wuji-technology/wuji-description/hand/attachment/wuji-hand-rl-open-source-base/BOM.xlsx

Preview | No. | Drawing No. / Spec (Model) | Part Name | Qty | Material | Finish | Brand | Type | Remark | File Name
 | 1 | 350x200x13 | Aluminum Optical Breadboard | 1 | AL6061-T6(SS) | Black Anodized |  | Standard Part |  | 350x200x13 Aluminum Optical Breadboard
 | 2 | Wuji Hand-RL Open-Source Fixture-01B | Base | 1 | PLA or other 3D printing material | N/A |  | Custom Part | 3D Printed | Wuji Hand-RL Open-Source Fixture-01B Base
