wuji-technology/wuji-description/hand/attachment/wuji-hand-rl-open-source-base/Assembly.STEP

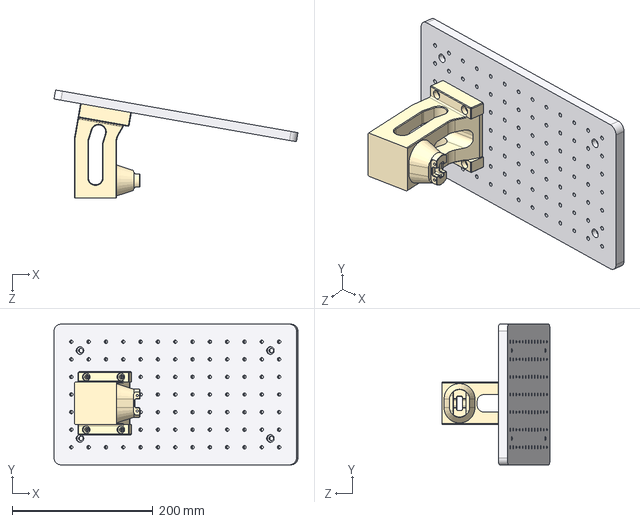
[picture p1: CAD file, 2026-06-10]
hand/attachment/wuji-hand-rl-open-source-base/Assembly.STEP
346.9 x 200.0 x 153.7 mm
Wuji Hand-RL Open-Source Fixture-01B Base
350x200x13 Aluminum Optical Breadboard
