wuji-technology/wuji-description/hand2/hand2_1/body/meshes/left/visual_nails/l_ring_finger_distal_black_remainder.STL

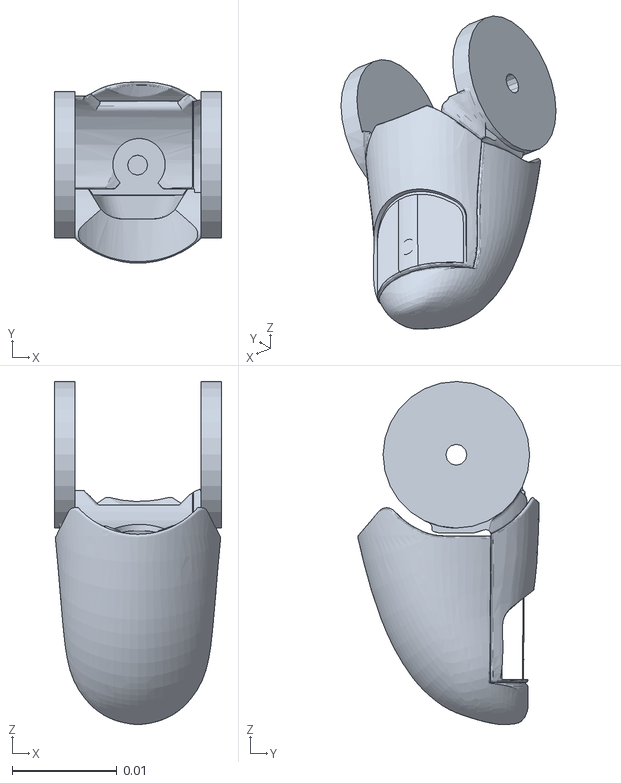
[picture p2: CAD file, 2026-10-26]
hand2/hand2_1/body/meshes/left/visual_nails/l_ring_finger_distal_black_remainder.STL
0.016 x 0.0173 x 0.0328
