wuji-technology/wuji-description/hand2/hand2_2/body/meshes/right/visual_nails/r_pinky_distal_black_remainder.STL

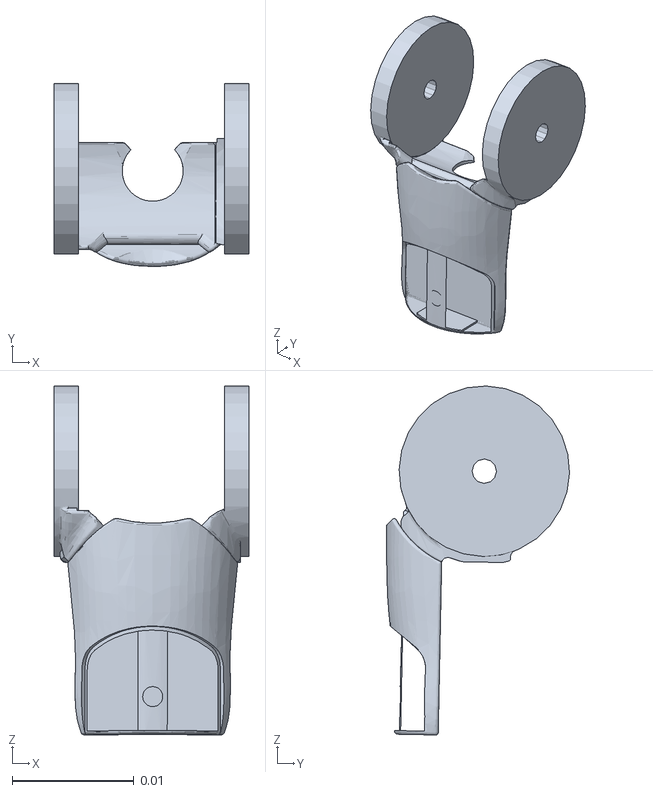
[picture p3: CAD file, 2026-10-26]
hand2/hand2_2/body/meshes/right/visual_nails/r_pinky_distal_black_remainder.STL
0.016 x 0.015 x 0.0287
