wuji-technology/wuji-description/glove/attachment/Pico-controller-attachment.STEP

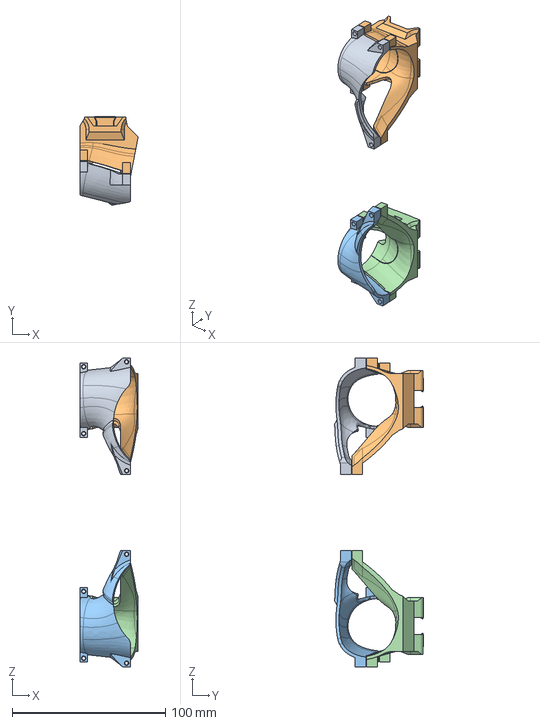
[picture p4: CAD file, 2026-10-26]
glove/attachment/Pico-controller-attachment.STEP
38.1 x 58.0 x 201.6 mm
