wuji-technology/wuji-description/glove/body/mesh/base_link_TX.STL

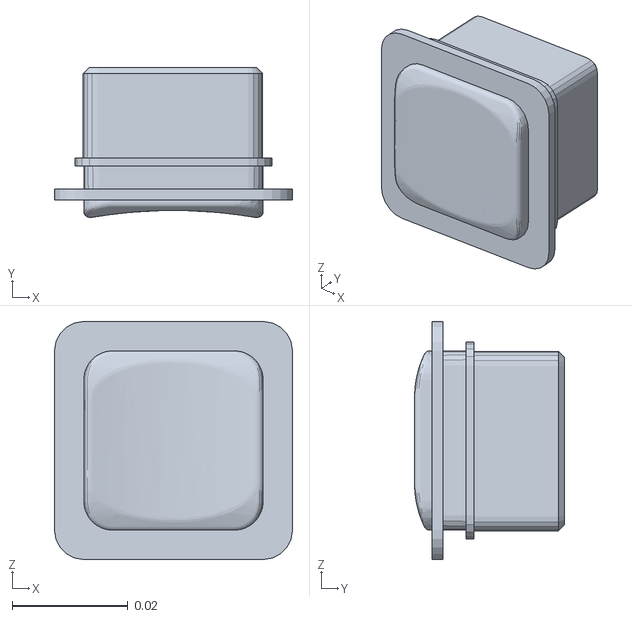
[picture p5: CAD file, 2026-09-11]
glove/body/mesh/base_link_TX.STL
0.0411 x 0.0259 x 0.0411
