wuji-technology/wuji-description/glove/body/step/EMFTXC_topcover.step

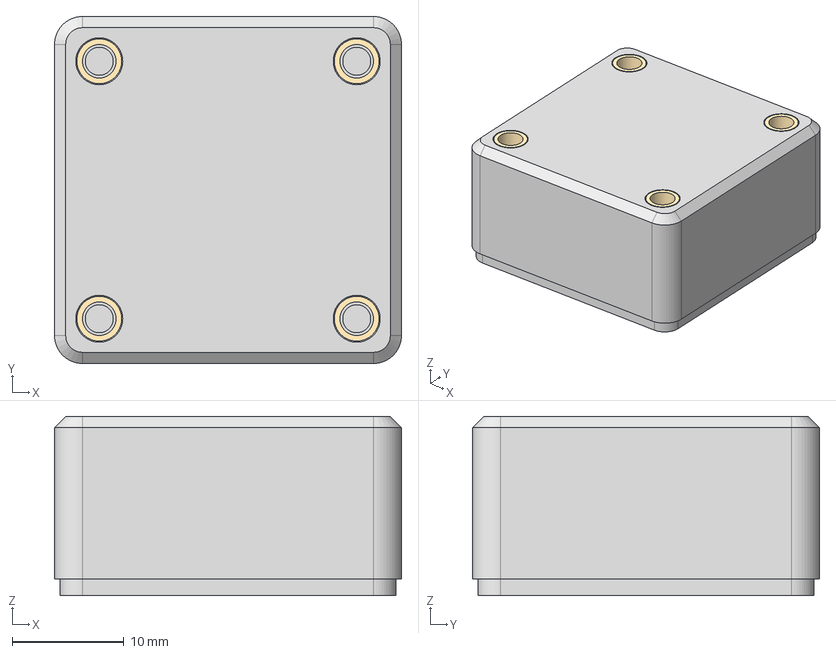
[picture p6: CAD file, 2026-06-04]
glove/body/step/EMFTXC_topcover.step
31.0 x 31.0 x 16.0 mm
M3_4.5_6
YC.JG.WJ01218
YC.JG.WJ01218_1
YC.JG.WJ01218_2
