wuji-technology/wuji-description/hand/attachment/impact-resistant-attachment/meshes/hand_docking_link.STL

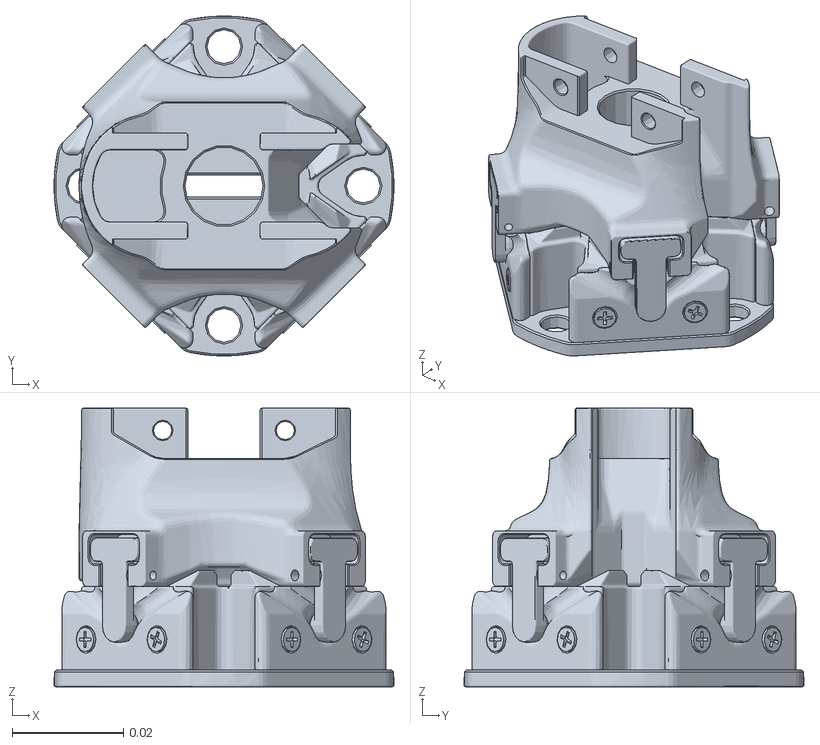
[picture p7: CAD file, 2026-05-18]
hand/attachment/impact-resistant-attachment/meshes/hand_docking_link.STL
0.061 x 0.061 x 0.05
