wuji-technology/wuji-description/hand/attachment/step/Impact-Resistant-Adapter.step

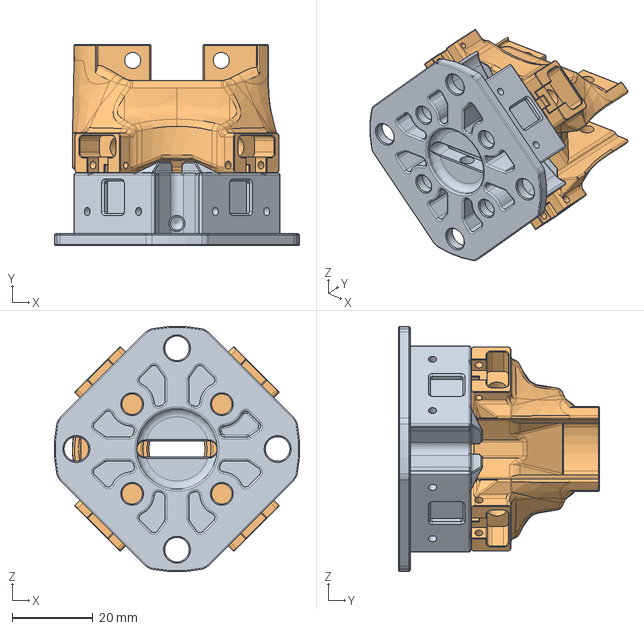
[picture p8: CAD file, 2026-05-18]
hand/attachment/step/Impact-Resistant-Adapter.step
60.9 x 50.0 x 60.9 mm
YC.JG.QX00600
YC.JG.QX00601
