wuji-technology/wuji-description/hand/attachment/unitree-g1-attachment/unitree-g1-docking-adapter.stl

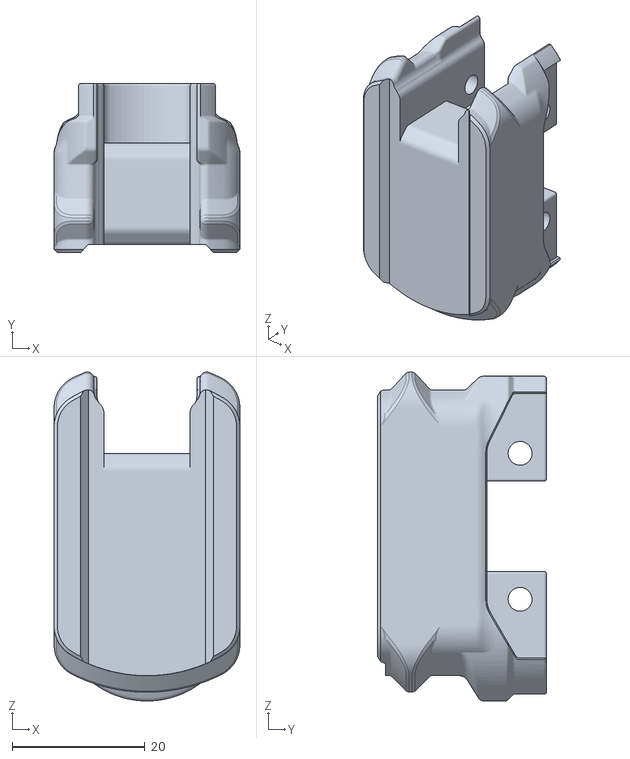
[picture p9: CAD file, 2026-05-18]
hand/attachment/unitree-g1-attachment/unitree-g1-docking-adapter.stl
28.0 x 25.5 x 49.6
