wuji-technology/wuji-description/hand/body-with-soft/meshes/left/left_finger5_link4_simplified.STL

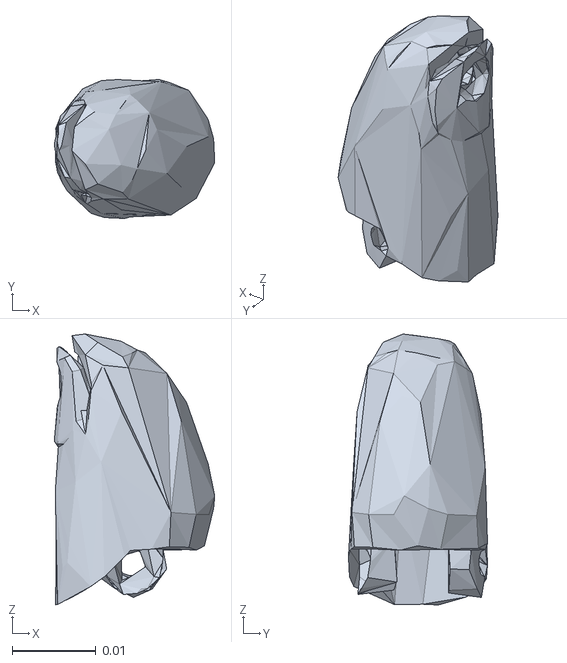
[picture p10: CAD file, 2026-06-10]
hand/body-with-soft/meshes/left/left_finger5_link4_simplified.STL
0.0191 x 0.0166 x 0.0323
