wuji-technology/wuji-description/hand/body-with-soft/meshes/right/right_finger1_link3.STL

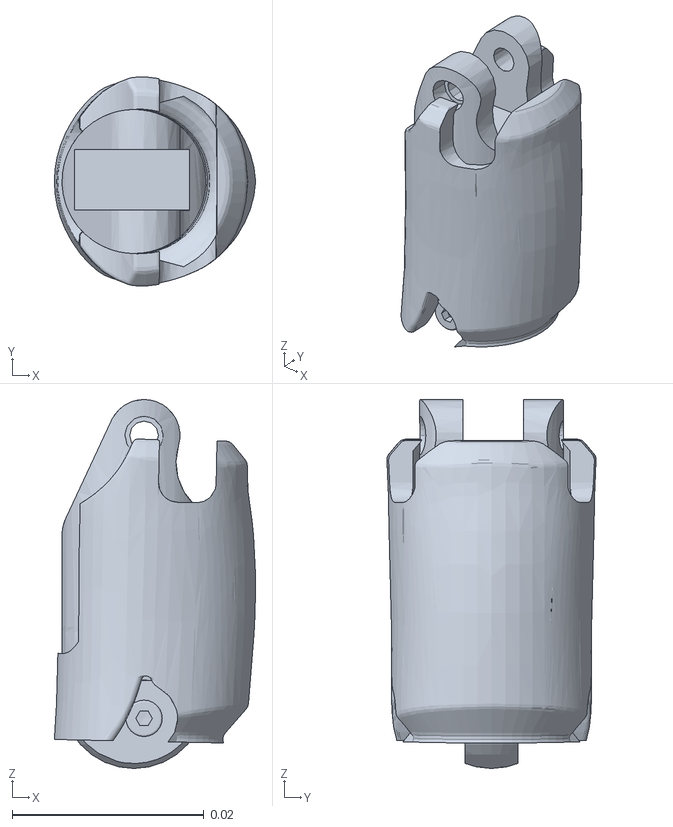
[picture p11: CAD file, 2026-06-10]
hand/body-with-soft/meshes/right/right_finger1_link3.STL
0.021 x 0.0218 x 0.0385
