wuji-technology/wuji-description/hand/body/step/WH_simplified_left_frame&temporarytips.STEP

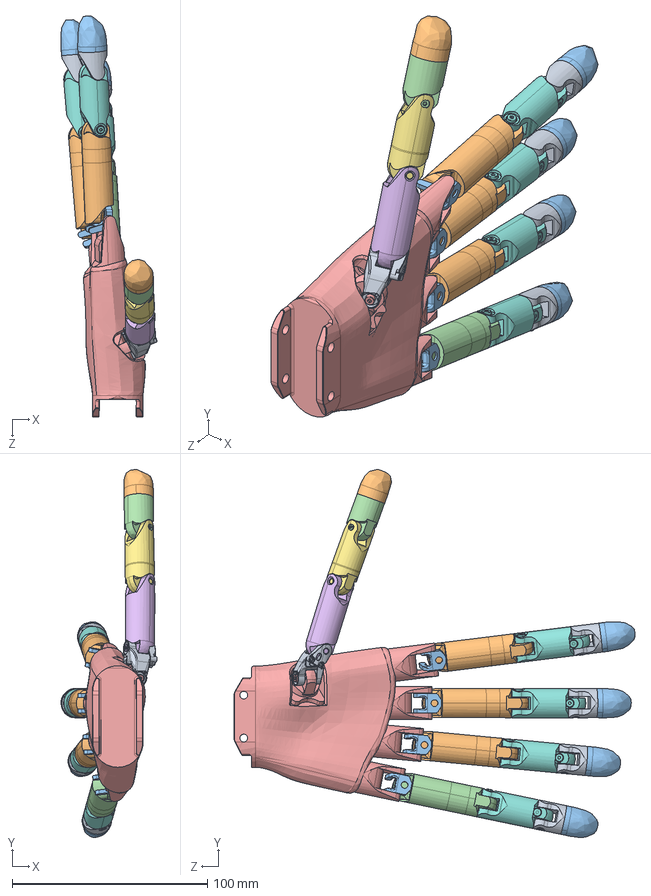
[picture p12: CAD file, 2026-05-18]
hand/body/step/WH_simplified_left_frame&temporarytips.STEP
49.3 x 188.8 x 205.5 mm
_X2_87178F6E87176746_X0_IP.step
MCP_joint_index.step
_X2_87178F6E87176746_X0_IP_2.step
MCP_joint_index_1.step
MCP_joint_index_2.step
_X2_87178F6E87176746_X0_IP_3.step
MCP_joint_index_3.step
_X2_87178F6E87176746_X0_IP_4.step
_X2_65E068079898_X0_.step
_X2_87178F6E87176746_X0_IP_1_3_1.step
UJ.WJ.AA.0005.step
_X2_53F3624B_X0_CMC_X2_4E004E8C8F748FDE63A54EF6673A52A07248_X0_ _v29.step
YC.JG.QX00006.step.step x 4
tipmount_index x 4
fingertip_thumb
UJ.WJ.AA.0004 x 4
IP_thumb
