wuji-technology/wuji-description/hand2/hand2_1/attachment/wuji-hand2-description-right-adapter_hand2_1_step.STEP

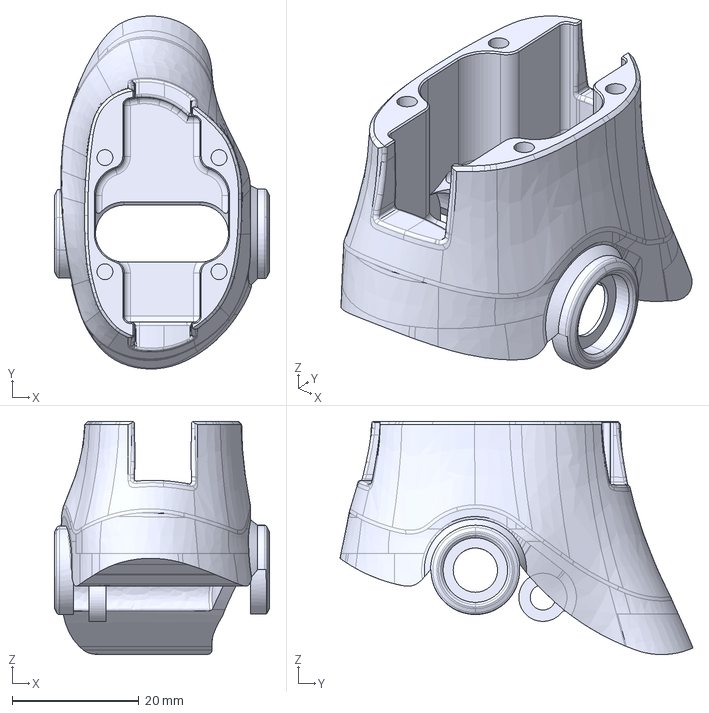
[picture p13: CAD file, 2026-10-26]
hand2/hand2_1/attachment/wuji-hand2-description-right-adapter_hand2_1_step.STEP
34.0 x 55.8 x 36.8 mm
