wuji-technology/wuji-description/hand2/hand2_1/body/meshes/left/l_ring_finger_middle_cover.STL

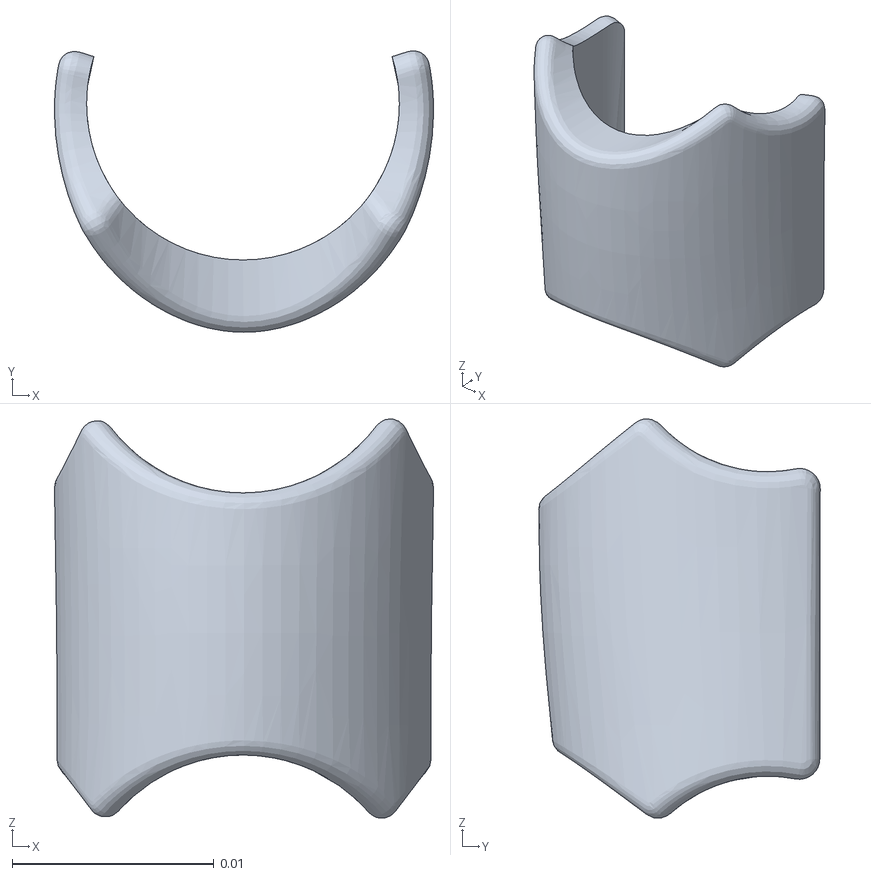
[picture p14: CAD file, 2026-10-26]
hand2/hand2_1/body/meshes/left/l_ring_finger_middle_cover.STL
0.0188 x 0.014 x 0.0198
