wuji-technology/wuji-description/hand2/hand2_1/body/meshes/right/r_thumb_palm_cover.STL

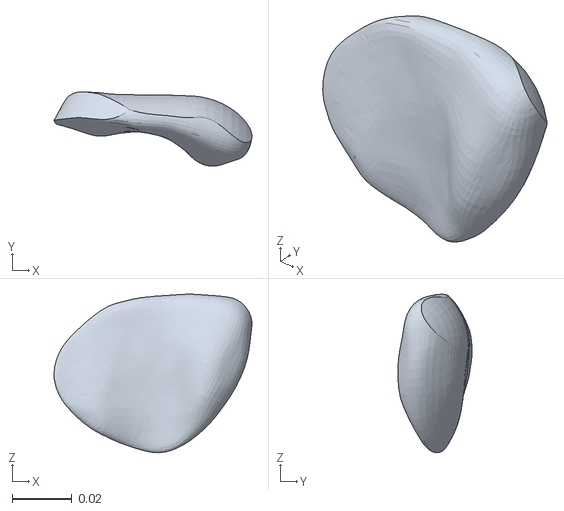
[picture p15: CAD file, 2026-10-26]
hand2/hand2_1/body/meshes/right/r_thumb_palm_cover.STL
0.0664 x 0.0249 x 0.0532
