wuji-technology/wuji-description/hand2/hand2_1/body/step/wuji-hand2-description-left_hand2_1_step.STEP

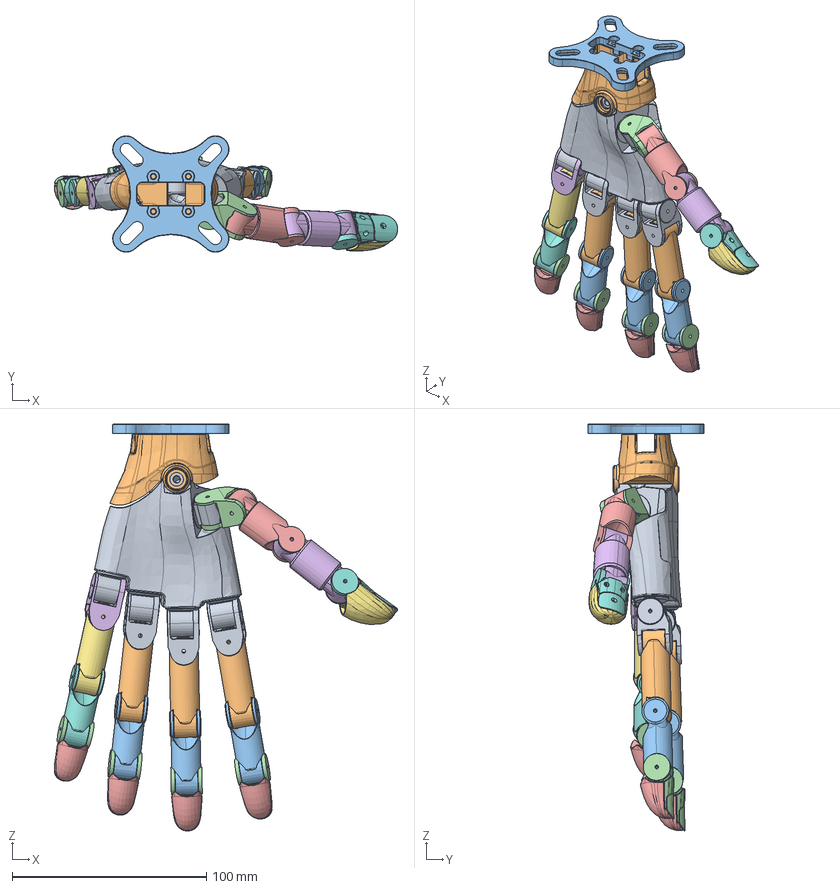
[picture p16: CAD file, 2026-11-10]
hand2/hand2_1/body/step/wuji-hand2-description-left_hand2_1_step.STEP
176.9 x 60.0 x 209.6 mm
l_transfer_001
flange_001
l_wrist_001 x 2
l_thumb_proximal_001
l_thumb_proximal_abd_001
l_thumb_middle_001
l_thumb-tip-sensor_001 x 2
l_thumb_tip_001 x 2
standard_finger_proximal_001 x 3
standard_finger_proximal_abd_001 x 3
standard_finger_middle_001 x 3
standard_tip_001 x 8
standard_tip_001_change x 8
pinky_finger_proximal_001
pinky_finger_proximal_abd_001
pinky_finger_middle_001
