wuji-technology/wuji-description/hand2/hand2_2/attachment/wuji-hand2-description-left-mount_hand2_2_step.STEP

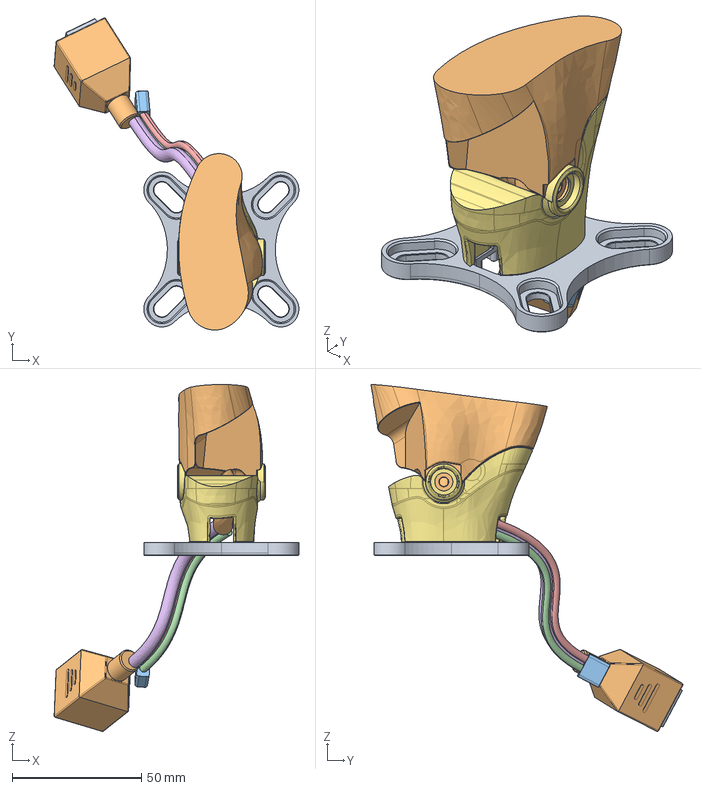
[picture p17: CAD file, 2026-08-14]
hand2/hand2_2/attachment/wuji-hand2-description-left-mount_hand2_2_step.STEP
94.6 x 120.6 x 134.1 mm
线束
WUJI二代灵巧手转接座_beta1版_ 0722
