wuji-technology/wuji-description/hand2/hand2_2/body/meshes/left/l_index_finger_proximal_abd_cover.STL

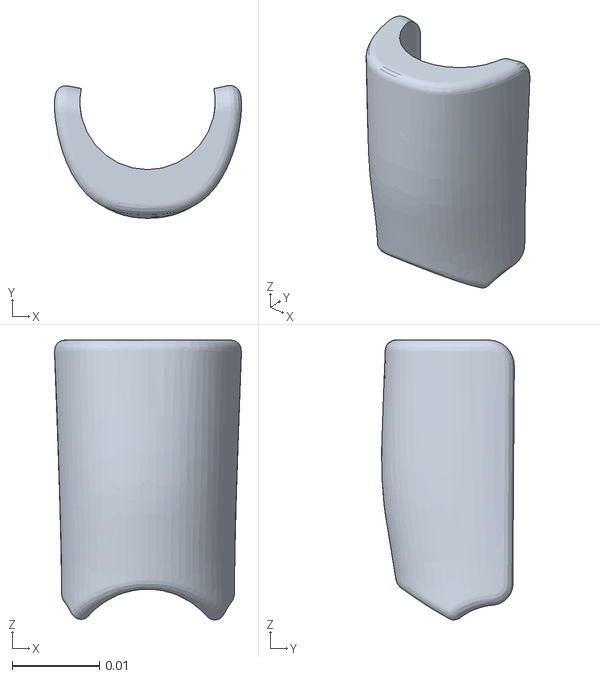
[picture p18: CAD file, 2026-10-26]
hand2/hand2_2/body/meshes/left/l_index_finger_proximal_abd_cover.STL
0.0214 x 0.0152 x 0.0321
