wuji-technology/wuji-description/hand2/hand2_2/body/meshes/left/visual_nails/l_middle_finger_distal_nail_cap.STL

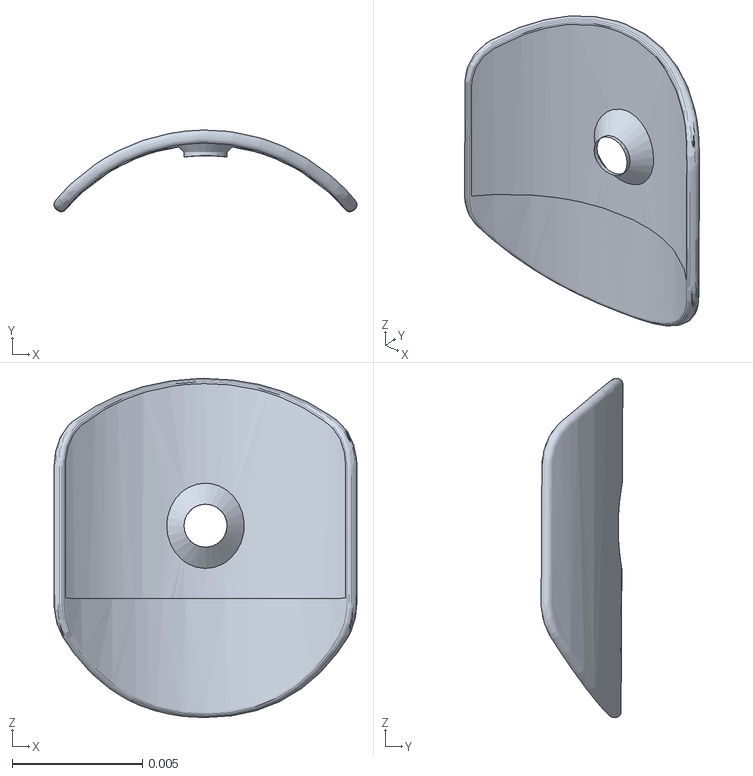
[picture p19: CAD file, 2026-10-26]
hand2/hand2_2/body/meshes/left/visual_nails/l_middle_finger_distal_nail_cap.STL
0.0116 x 0.00314 x 0.013
