wuji-technology/wuji-description/hand2/hand2_2/body/meshes/right/r_thenar_cover.STL

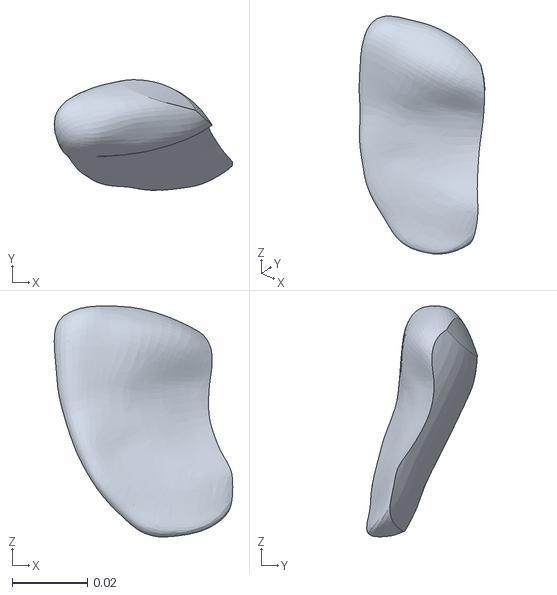
[picture p20: CAD file, 2026-10-26]
hand2/hand2_2/body/meshes/right/r_thenar_cover.STL
0.0476 x 0.0295 x 0.0616
