wuji-technology/wuji-description/hand2/hand2_beta1/attachment/wuji-hand2-description-right-mount_beta1_step.STEP

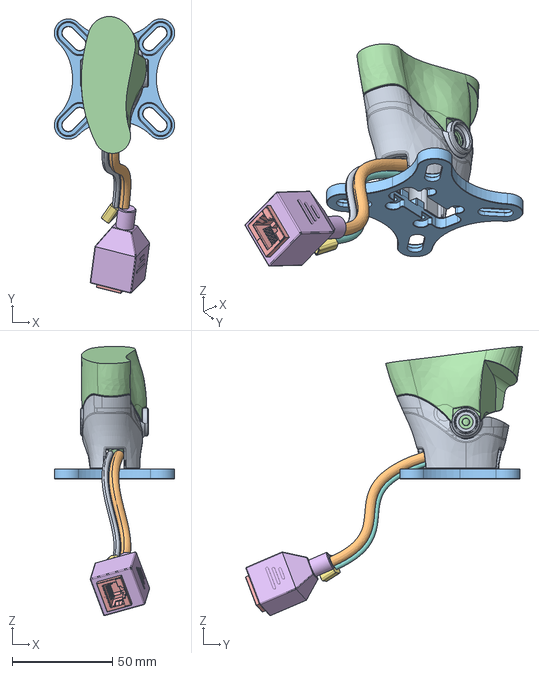
[picture p21: CAD file, 2026-08-14]
hand2/hand2_beta1/attachment/wuji-hand2-description-right-mount_beta1_step.STEP
59.9 x 138.0 x 134.1 mm
WUJI二代灵巧手转接座_beta1版_ 0722
线束
