wuji-technology/wuji-description/hand2/hand2_beta1/body/meshes/left/l_mount.STL

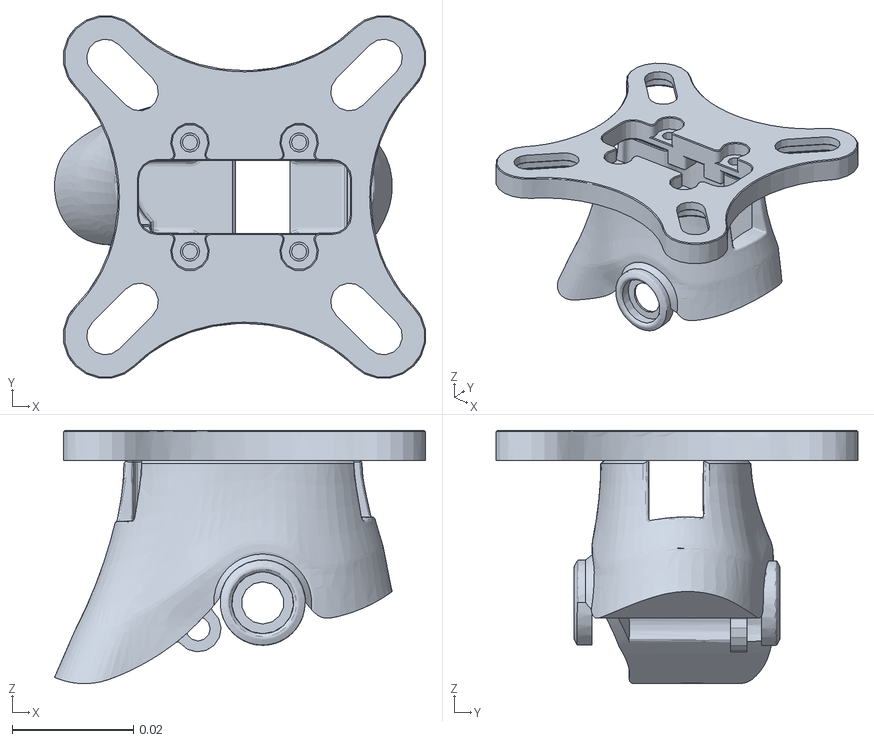
[picture p22: CAD file, 2026-08-14]
hand2/hand2_beta1/body/meshes/left/l_mount.STL
0.0613 x 0.0598 x 0.0418
