wuji-technology/wuji-description/hand2/hand2_beta2/body/meshes/left/l_index_finger_tip_sensor_frame.STL

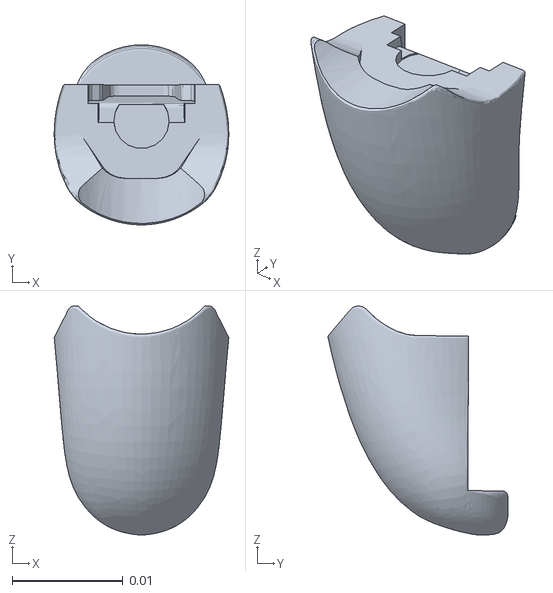
[picture p23: CAD file, 2026-08-14]
hand2/hand2_beta2/body/meshes/left/l_index_finger_tip_sensor_frame.STL
0.0158 x 0.0163 x 0.0207
