wuji-technology/wuji-description/hand2/hand2_beta2/body/meshes/right/r_index_finger_middle.STL

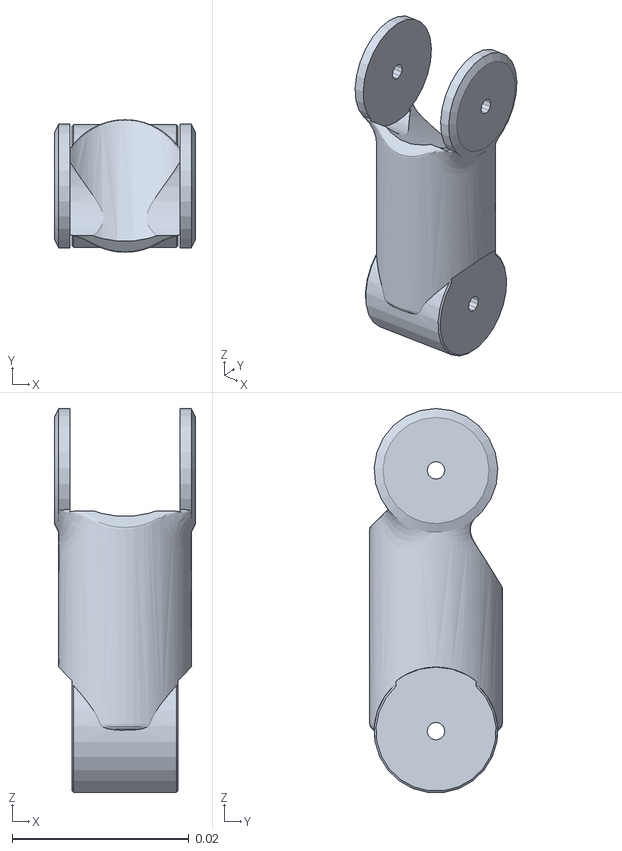
[picture p24: CAD file, 2026-08-14]
hand2/hand2_beta2/body/meshes/right/r_index_finger_middle.STL
0.016 x 0.015 x 0.0434
