wuji-technology/wuji-description/glove/attachment/Wuji-glove-attachment.STEP

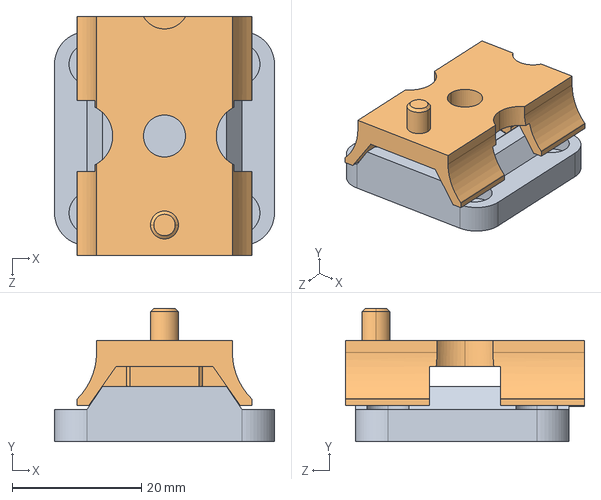
[picture p25: CAD file, 2026-07-14]
glove/attachment/Wuji-glove-attachment.STEP
34.0 x 20.6 x 37.0 mm
wuji glove插销件-v2
手腕插销件-v23
