wuji-technology/wuji-description/glove/body/mesh/base_link_RX.STL

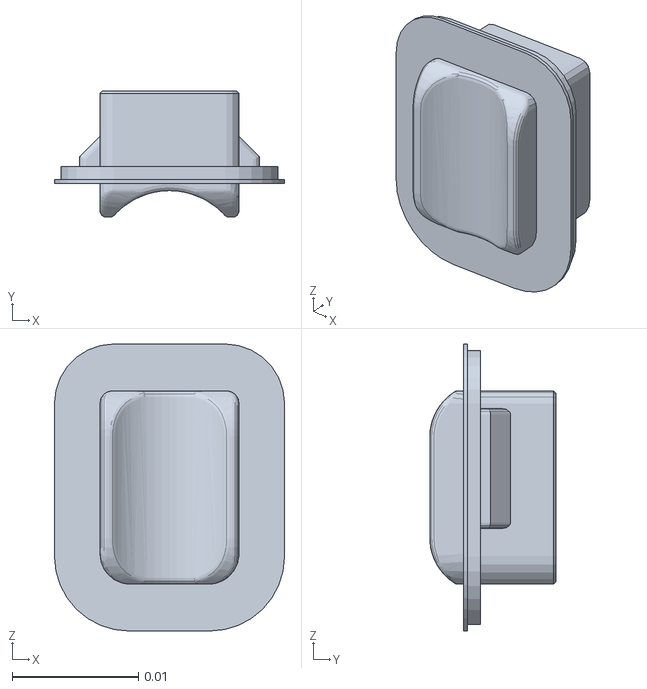
[picture p26: CAD file, 2026-06-04]
glove/body/mesh/base_link_RX.STL
0.0182 x 0.01 x 0.0227
