wuji-technology/wuji-description/hand/attachment/step/Direct-Adapter-Mount.step

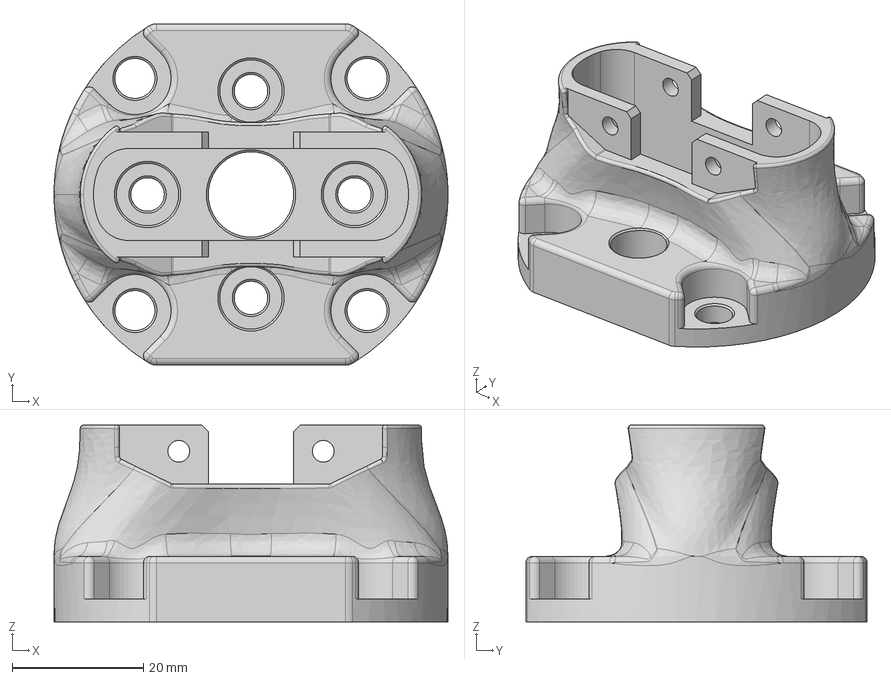
[picture p27: CAD file, 2026-05-18]
hand/attachment/step/Direct-Adapter-Mount.step
60.0 x 52.0 x 30.0 mm
