wuji-technology/wuji-description/hand/attachment/wuji-hand-rl-open-source-base/Base.3mf

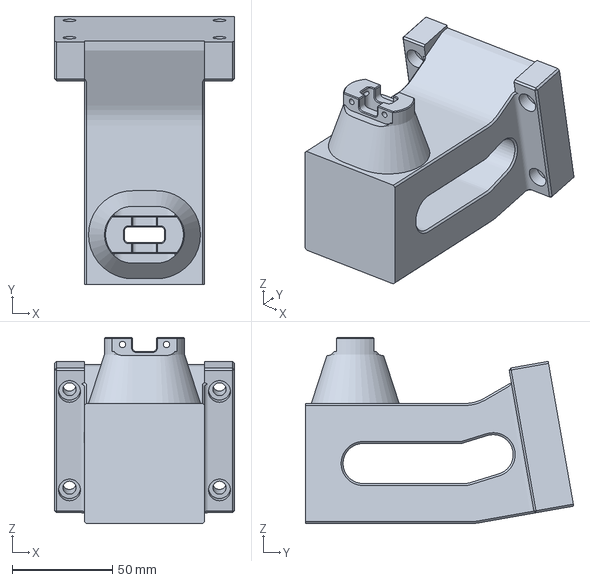
[picture p28: CAD file, 2026-06-10]
hand/attachment/wuji-hand-rl-open-source-base/Base.3mf
90.0 x 134.2 x 93.0 mm
