wuji-technology/wuji-description/hand/body-with-soft/meshes/left/left_finger4_link3.STL

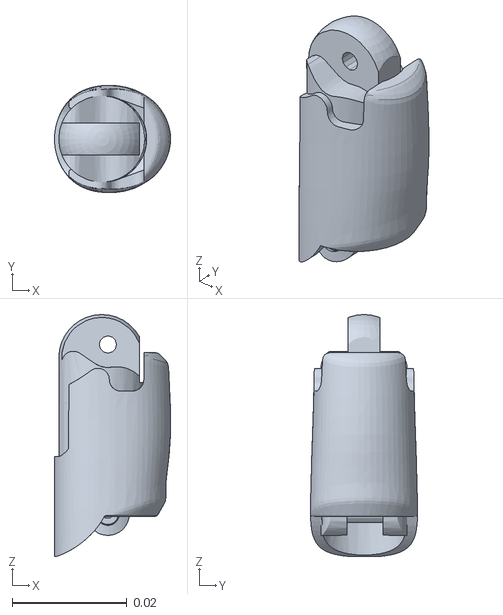
[picture p29: CAD file, 2026-06-10]
hand/body-with-soft/meshes/left/left_finger4_link3.STL
0.0202 x 0.0187 x 0.0422
