wuji-technology/wuji-description/hand/body-with-soft/meshes/right/right_finger5_link3.STL

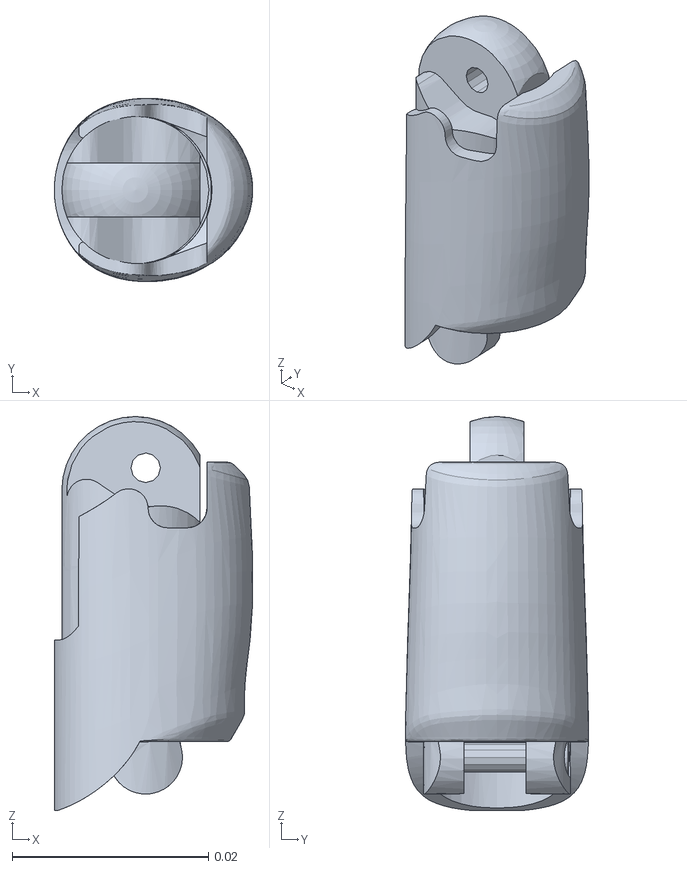
[picture p30: CAD file, 2026-06-10]
hand/body-with-soft/meshes/right/right_finger5_link3.STL
0.0202 x 0.0187 x 0.0402
