wuji-technology/wuji-description/hand/body/step/WH_simplified_right_frame&temporarytips.STEP

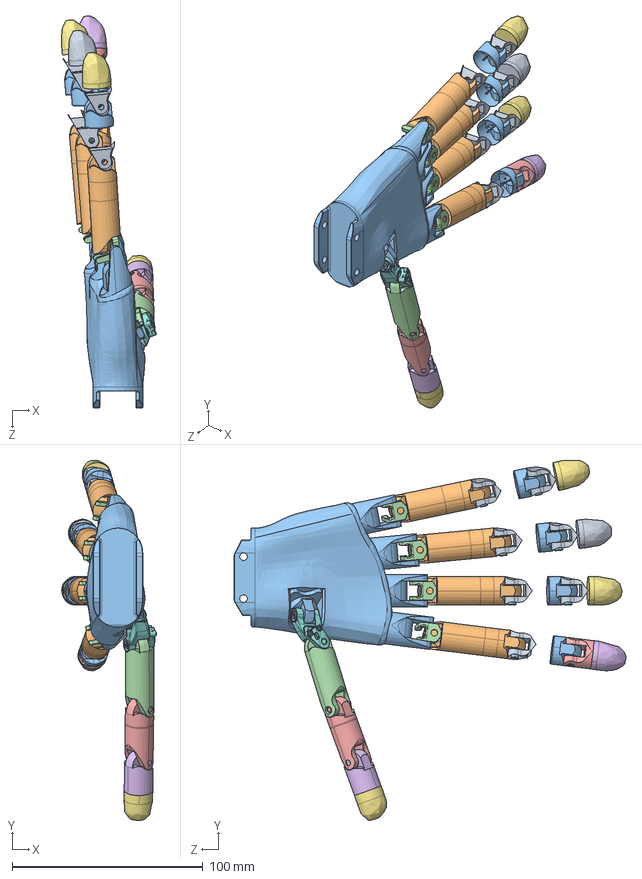
[picture p31: CAD file, 2026-05-18]
hand/body/step/WH_simplified_right_frame&temporarytips.STEP
49.7 x 189.0 x 205.5 mm
_X2_87178F6E87176746_X0_IP
_X2_87178F6E87176746_X0_IP_1
MCP_joint_index
tipmount_index
UJ.WJ.AA.0004
UJ.WJ.AA.0004_1
tipmount_middle
_X2_87178F6E87176746_X0_IP_2
_X2_87178F6E87176746_X0_IP_1_1
MCP_joint_index_1
MCP_joint_index_2
_X2_87178F6E87176746_X0_IP_3
_X2_87178F6E87176746_X0_IP_1_2
UJ.WJ.AA.0004_2
tipmount_ring
MCP_joint_index_3
_X2_87178F6E87176746_X0_IP_1_3
UJ.WJ.AA.0004_3
tipmount_pinky
_X2_87178F6E87176746_X0_IP_4
_X2_65E068079898_X0_
_X2_87178F6E87176746_X0_IP_1_3_1
UJ.WJ.AA.0005
IP_thumb
fingertip_thumb
_X2_53F3624B_X0_CMC_X2_4E004E8C8F748FDE63A54EF6673A52A07248_X0_ _v29
