wuji-technology/wuji-description/hand2/hand2_1/body/meshes/left/l_palm_middle_cover.STL

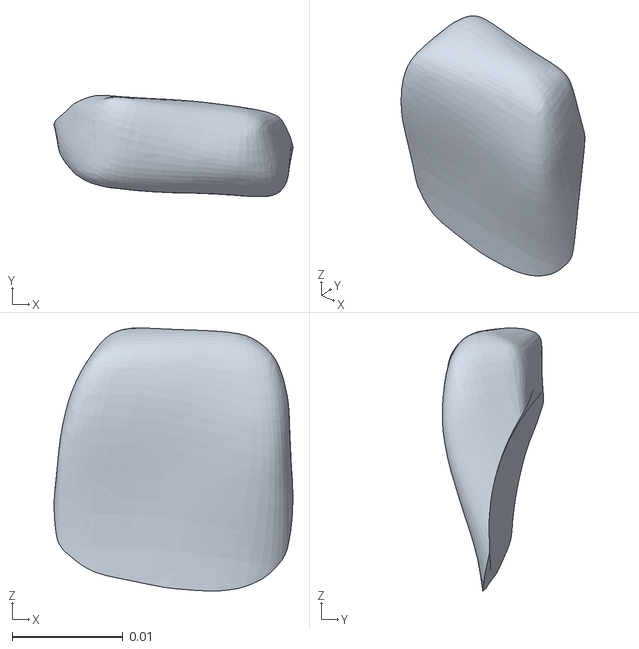
[picture p32: CAD file, 2026-10-26]
hand2/hand2_1/body/meshes/left/l_palm_middle_cover.STL
0.0216 x 0.00916 x 0.0237
