wuji-technology/wuji-description/hand2/hand2_1/body/meshes/right/r_ring_palm_cover.STL

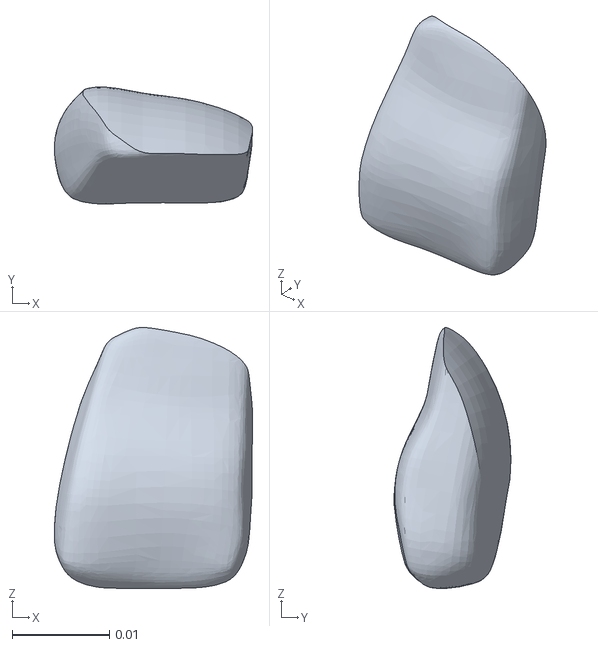
[picture p33: CAD file, 2026-10-26]
hand2/hand2_1/body/meshes/right/r_ring_palm_cover.STL
0.0204 x 0.012 x 0.0269
