wuji-technology/wuji-description/hand2/hand2_1/body/meshes/right/visual_nails/r_pinky_distal_nail_cap.STL

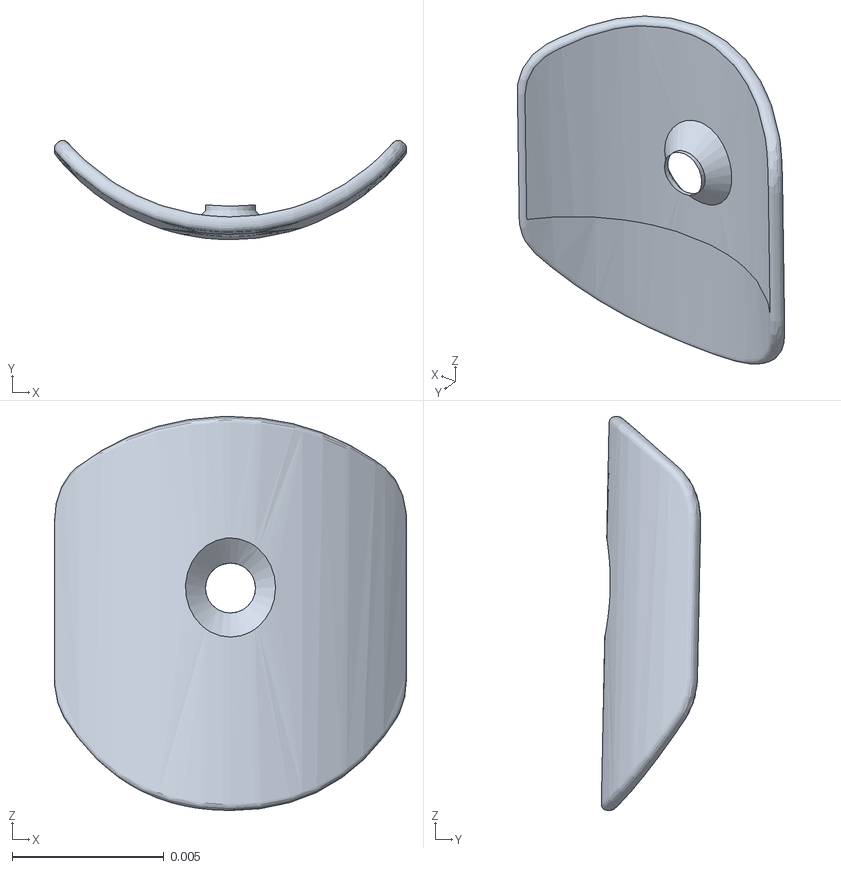
[picture p34: CAD file, 2026-10-26]
hand2/hand2_1/body/meshes/right/visual_nails/r_pinky_distal_nail_cap.STL
0.0116 x 0.00328 x 0.013
