wuji-technology/wuji-description/hand2/hand2_2/body/meshes/left/l_index_palm_cover.STL

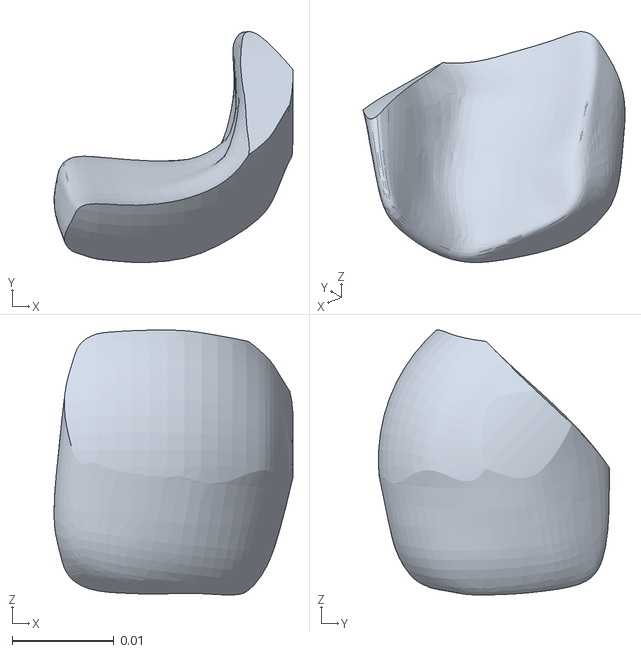
[picture p35: CAD file, 2026-10-26]
hand2/hand2_2/body/meshes/left/l_index_palm_cover.STL
0.0235 x 0.0227 x 0.0261
