wuji-technology/wuji-description/hand2/hand2_2/body/meshes/right/r_palm_index_cover.STL

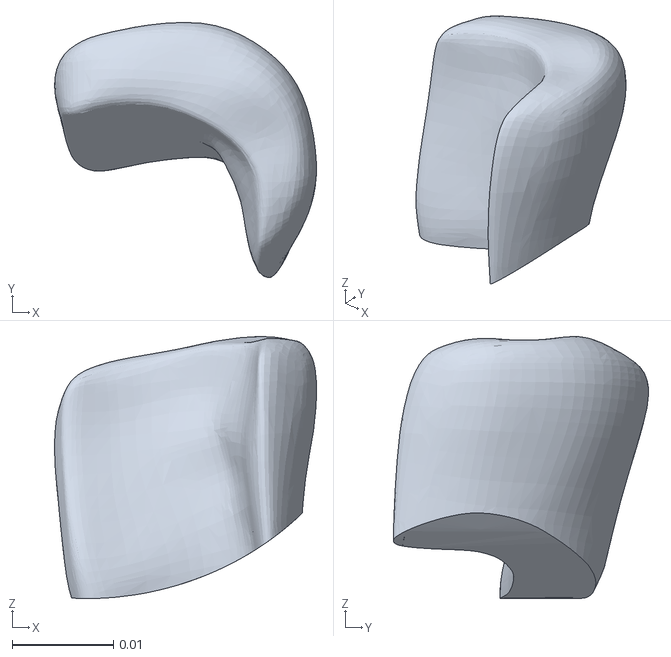
[picture p36: CAD file, 2026-10-26]
hand2/hand2_2/body/meshes/right/r_palm_index_cover.STL
0.0259 x 0.0252 x 0.0259
