wuji-technology/wuji-description/hand2/hand2_beta1/body/meshes/left/l_ring_finger_distal.STL

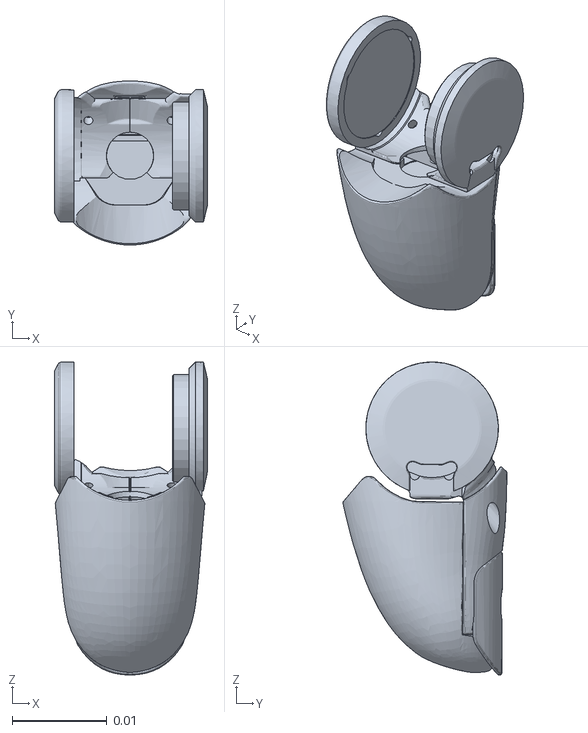
[picture p37: CAD file, 2026-07-23]
hand2/hand2_beta1/body/meshes/left/l_ring_finger_distal.STL
0.0162 x 0.0173 x 0.033
