wuji-technology/wuji-description/hand2/hand2_beta2/body/meshes/right/r_middle_finger_distal.STL

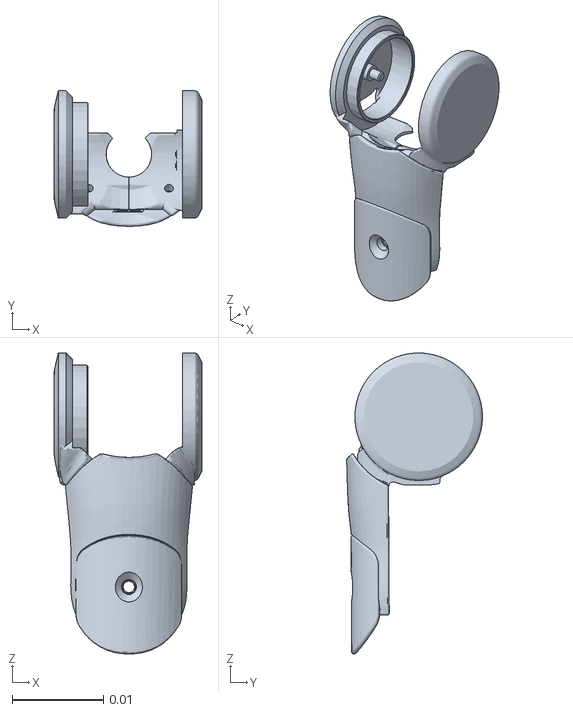
[picture p38: CAD file, 2026-08-14]
hand2/hand2_beta2/body/meshes/right/r_middle_finger_distal.STL
0.0162 x 0.0149 x 0.033
