wuji-technology/wuji-description/glove/attachment/Pico-tracker-attachment.STEP

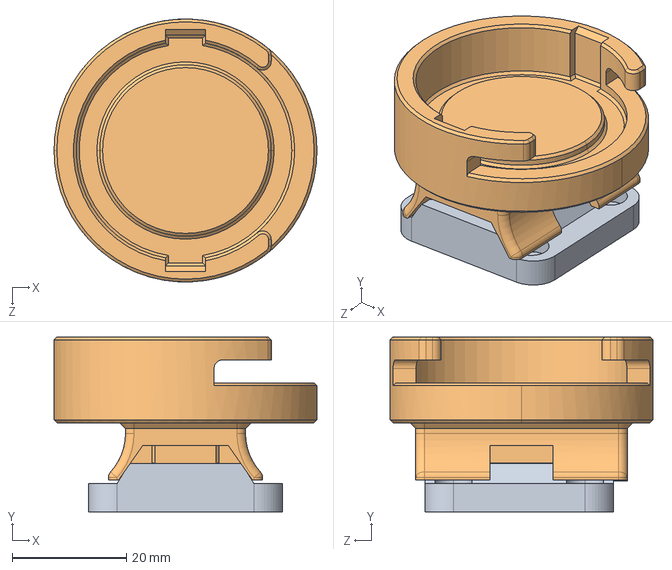
[picture p39: CAD file, 2026-07-14]
glove/attachment/Pico-tracker-attachment.STEP
46.0 x 30.6 x 46.0 mm
wuji glove插销件-v2
手腕插销件-v23
