wuji-technology/wuji-description/hand/body-with-soft/meshes/left/left_finger2_link2.STL

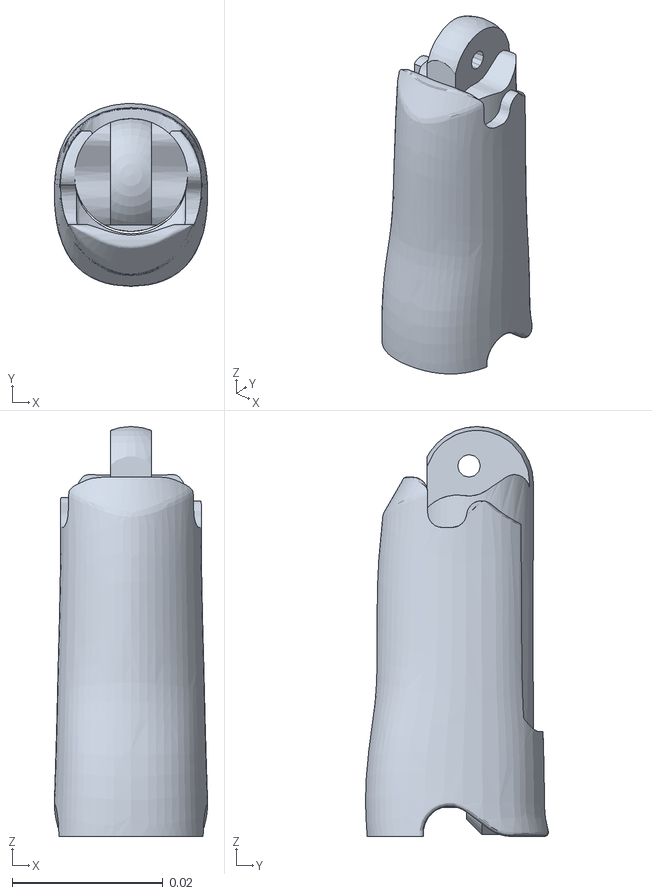
[picture p40: CAD file, 2026-06-10]
hand/body-with-soft/meshes/left/left_finger2_link2.STL
0.0204 x 0.0243 x 0.0544
