wuji-technology/wuji-description/hand2/hand2_beta2/body/meshes/left/l_middle_finger_proximal_abd.STL

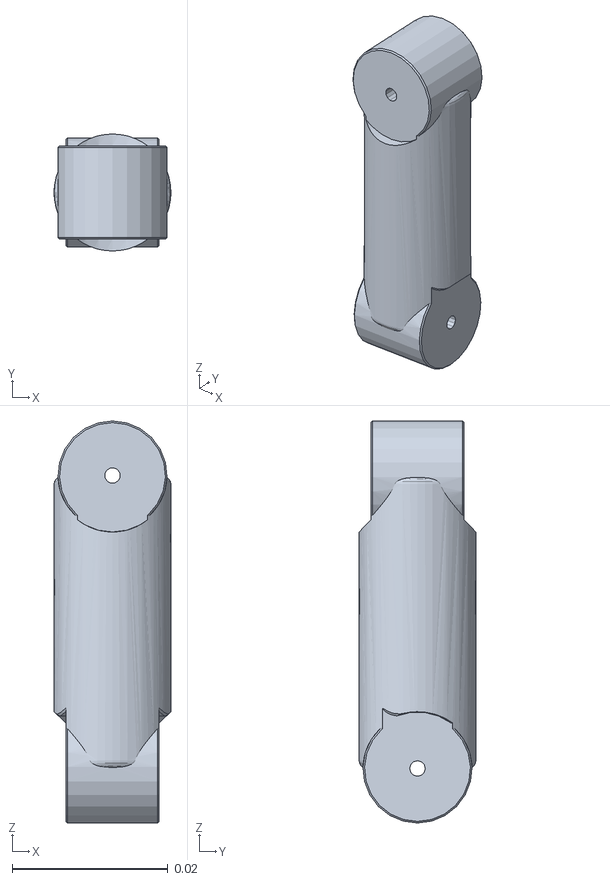
[picture p41: CAD file, 2026-08-14]
hand2/hand2_beta2/body/meshes/left/l_middle_finger_proximal_abd.STL
0.015 x 0.015 x 0.0516
