wuji-technology/wuji-description/hand/body-with-soft/meshes/right/right_finger1_link2_softbody_simplified.STL

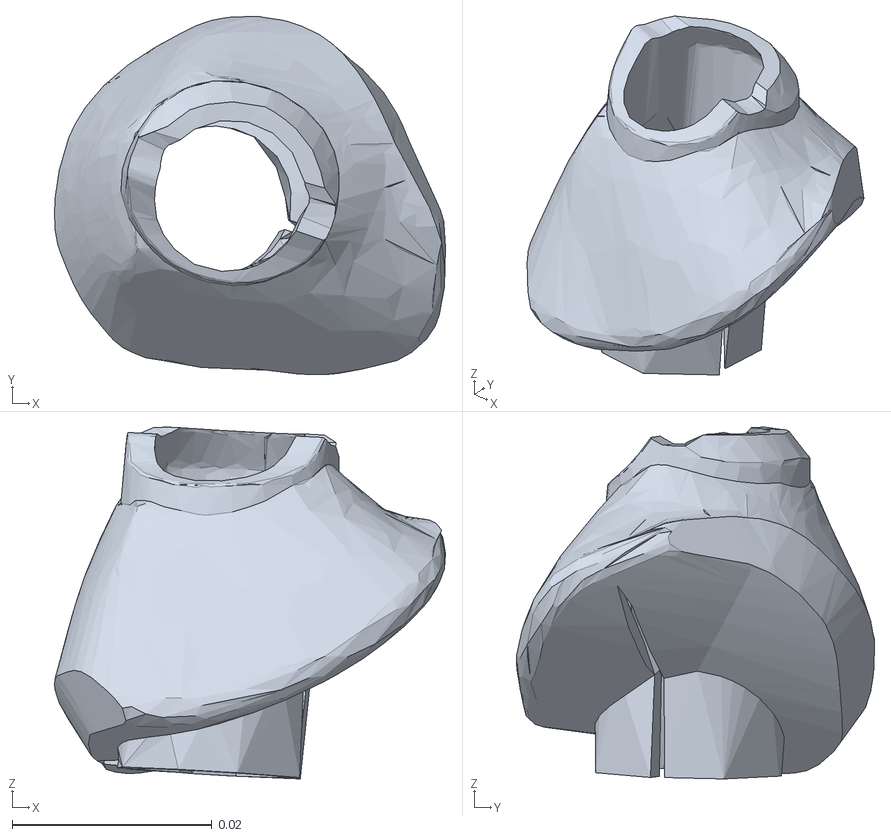
[picture p42: CAD file, 2026-06-10]
hand/body-with-soft/meshes/right/right_finger1_link2_softbody_simplified.STL
0.0392 x 0.0359 x 0.0353
