wuji-technology/wuji-description/hand2/hand2_1/body/meshes/left/l_thumb_distal.STL

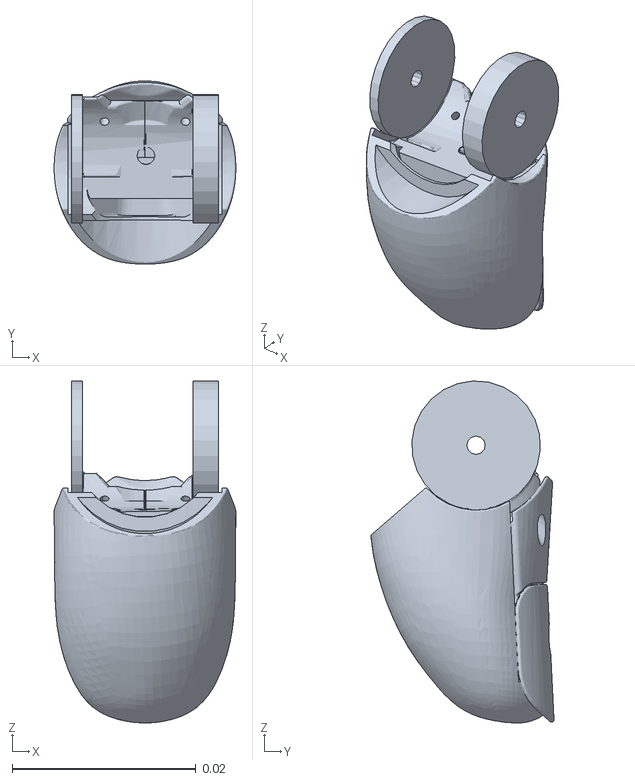
[picture p43: CAD file, 2026-10-12]
hand2/hand2_1/body/meshes/left/l_thumb_distal.STL
0.0198 x 0.0199 x 0.0372
