wuji-technology/wuji-description/hand2/hand2_2/body/meshes/left/l_pinky_middle_cover.STL

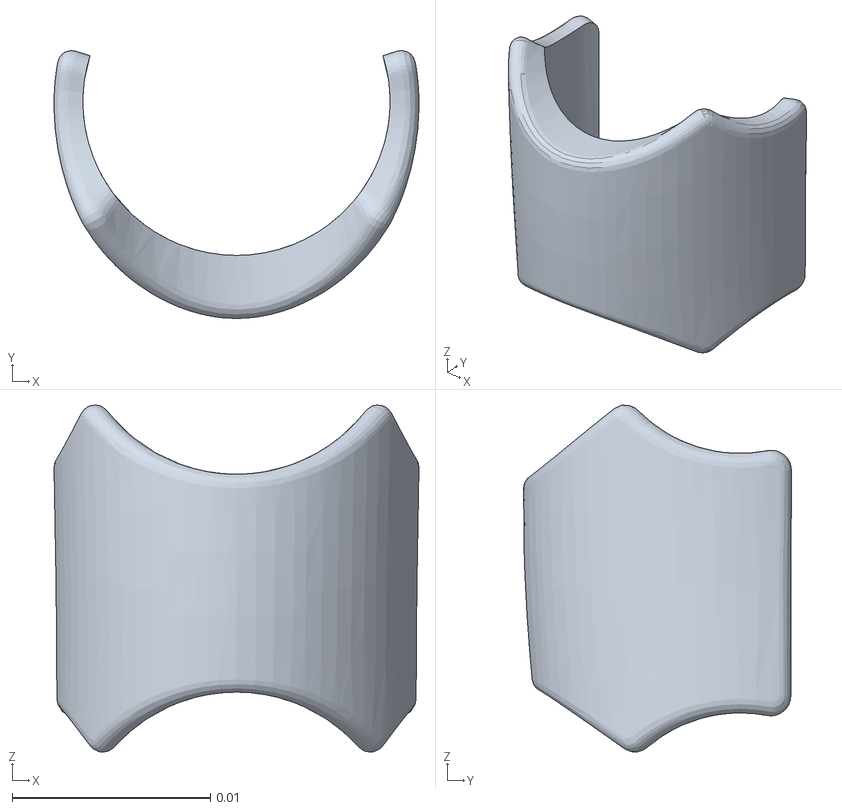
[picture p44: CAD file, 2026-10-26]
hand2/hand2_2/body/meshes/left/l_pinky_middle_cover.STL
0.0184 x 0.0135 x 0.0175
