wuji-technology/wuji-description/hand2/hand2_2/body/meshes/right/r_palm_ring_cover.STL

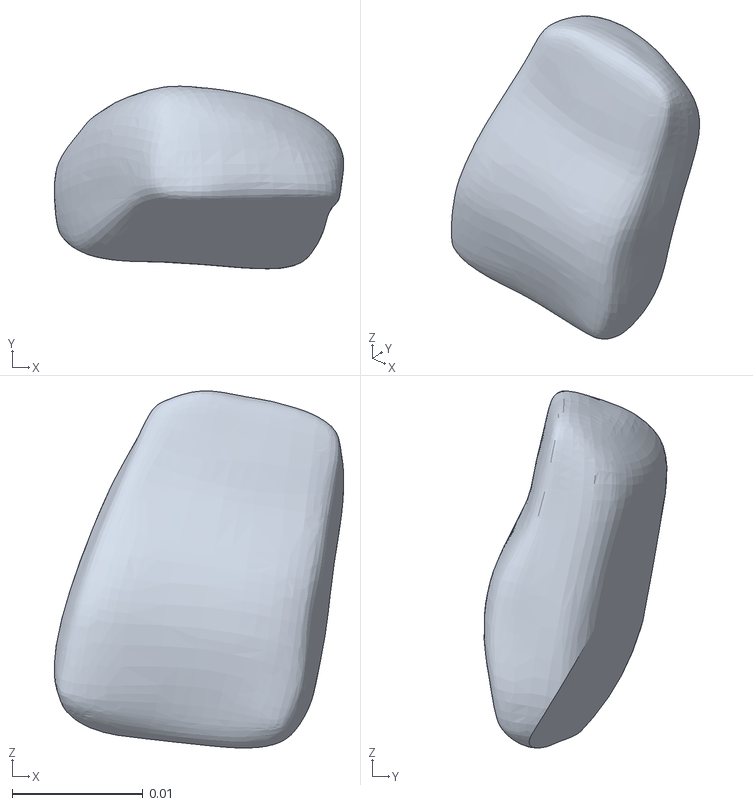
[picture p45: CAD file, 2026-10-26]
hand2/hand2_2/body/meshes/right/r_palm_ring_cover.STL
0.0221 x 0.014 x 0.0273
