wuji-technology/wuji-description/hand2/hand2_beta1/body/meshes/left/l_thumb_distal.STL

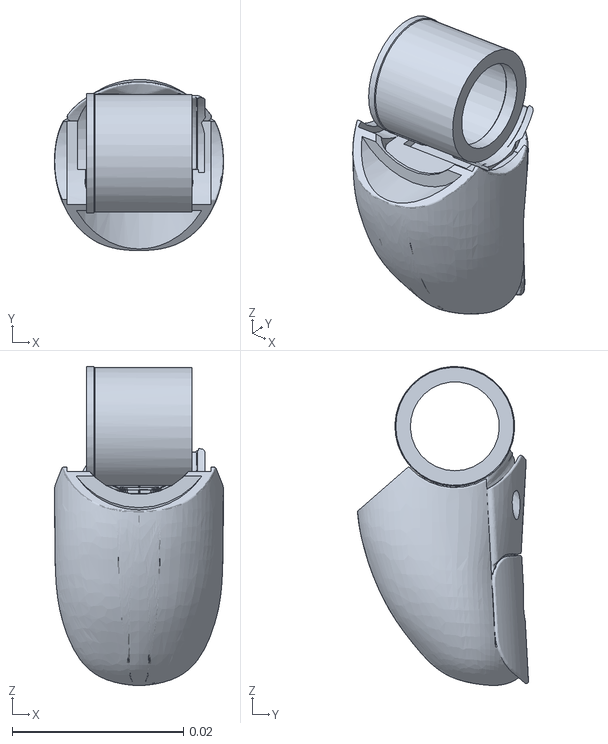
[picture p46: CAD file, 2026-07-23]
hand2/hand2_beta1/body/meshes/left/l_thumb_distal.STL
0.0198 x 0.02 x 0.0373
