wuji-technology/wuji-description/hand/body-with-soft/meshes/left/left_finger1_tip_link.STL

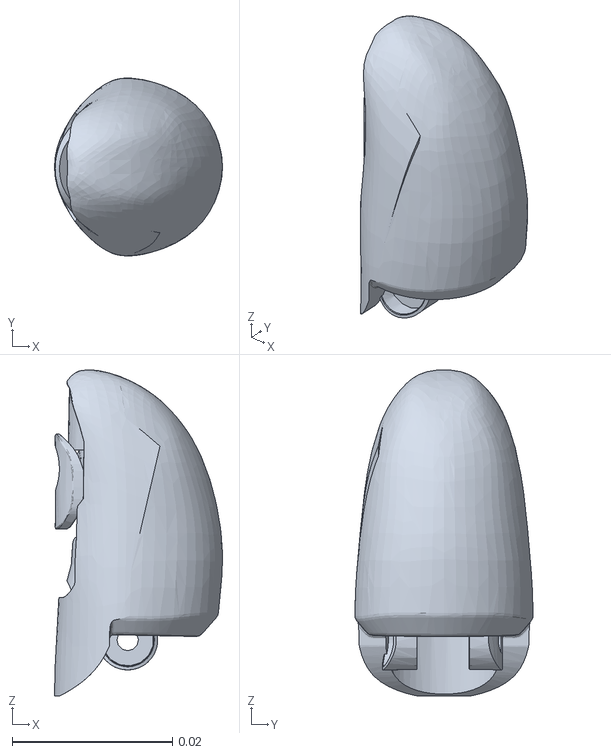
[picture p47: CAD file, 2026-06-10]
hand/body-with-soft/meshes/left/left_finger1_tip_link.STL
0.021 x 0.0222 x 0.0407
