wuji-technology/wuji-description/hand/body-with-soft/meshes/right/right_finger4_link4_simplified.STL

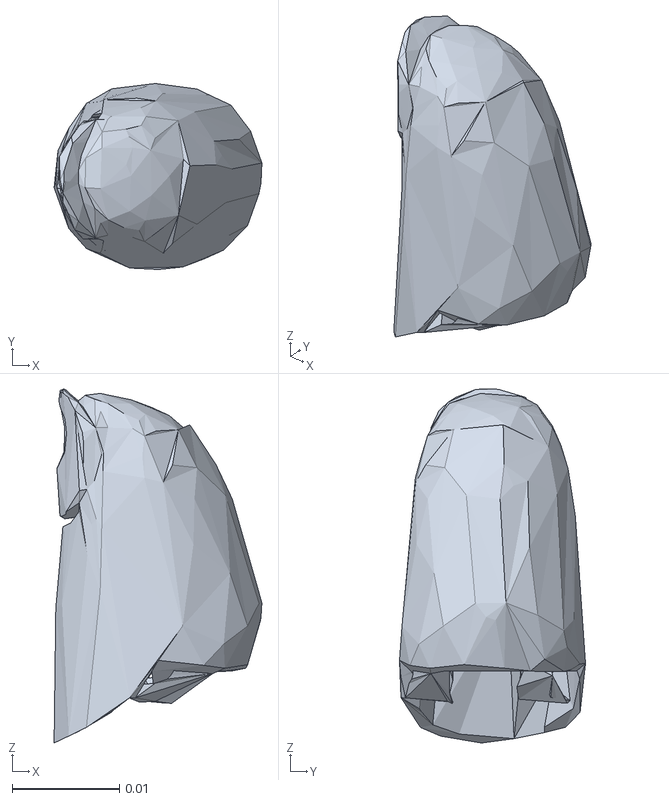
[picture p48: CAD file, 2026-06-10]
hand/body-with-soft/meshes/right/right_finger4_link4_simplified.STL
0.0193 x 0.0173 x 0.0329
