wuji-technology/wuji-description/hand2/hand2_1/body/meshes/right/r_adductor_pollicis_cover.STL

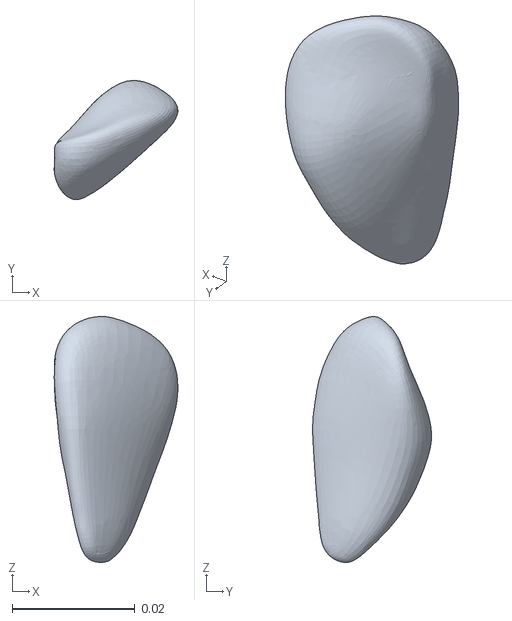
[picture p49: CAD file, 2026-10-26]
hand2/hand2_1/body/meshes/right/r_adductor_pollicis_cover.STL
0.0202 x 0.0194 x 0.0402
