wuji-technology/wuji-description/hand2/hand2_beta1/body/meshes/right/r_ring_finger_proximal.STL

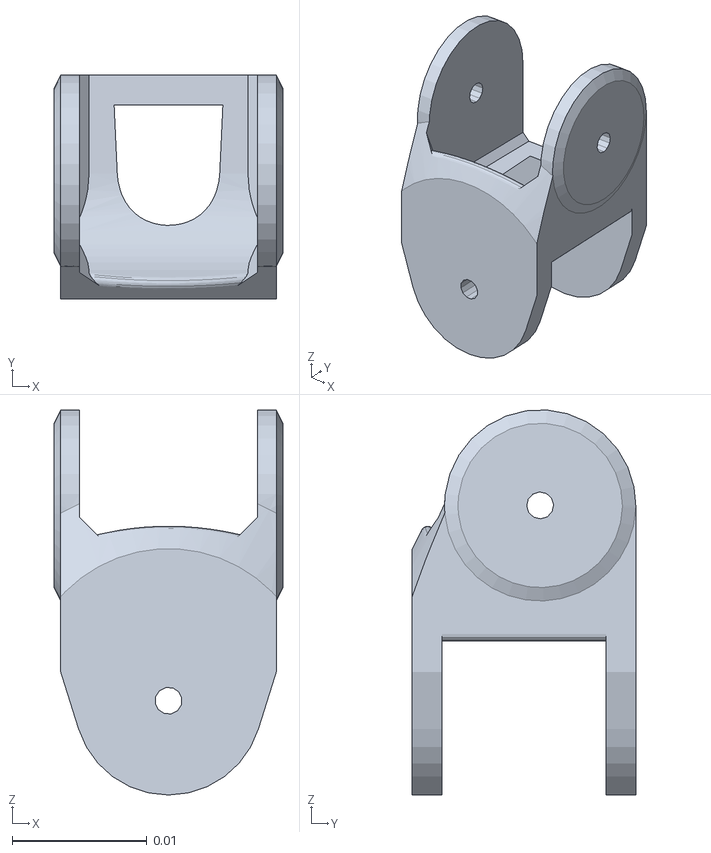
[picture p50: CAD file, 2026-07-23]
hand2/hand2_beta1/body/meshes/right/r_ring_finger_proximal.STL
0.017 x 0.0166 x 0.0286
