wuji-technology/wuji-description/hand/body-with-soft/meshes/right/right_palm_link.STL

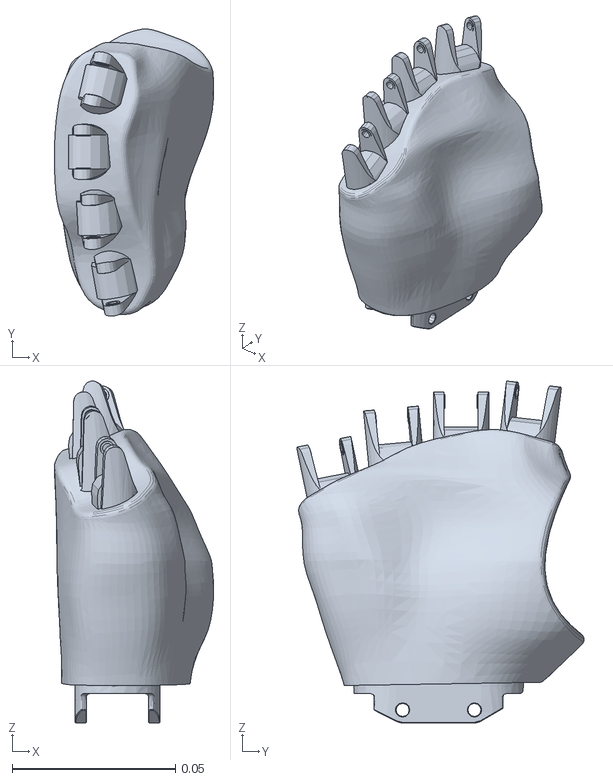
[picture p51: CAD file, 2026-06-10]
hand/body-with-soft/meshes/right/right_palm_link.STL
0.0488 x 0.0881 x 0.105
