wuji-technology/wuji-description/hand2/hand2_1/body/meshes/left/l_pinky_tip.STL

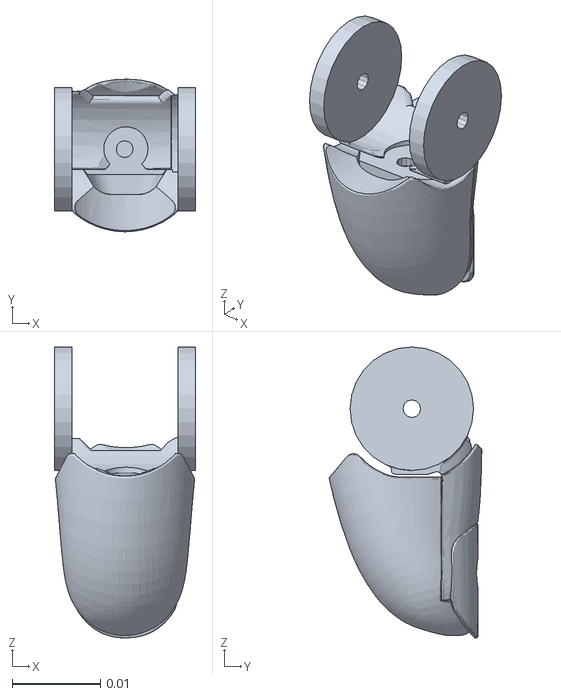
[picture p52: CAD file, 2026-10-12]
hand2/hand2_1/body/meshes/left/l_pinky_tip.STL
0.016 x 0.0173 x 0.033
