wuji-technology/wuji-description/hand2/hand2_1/body/meshes/right/r_midpalm_cover.STL

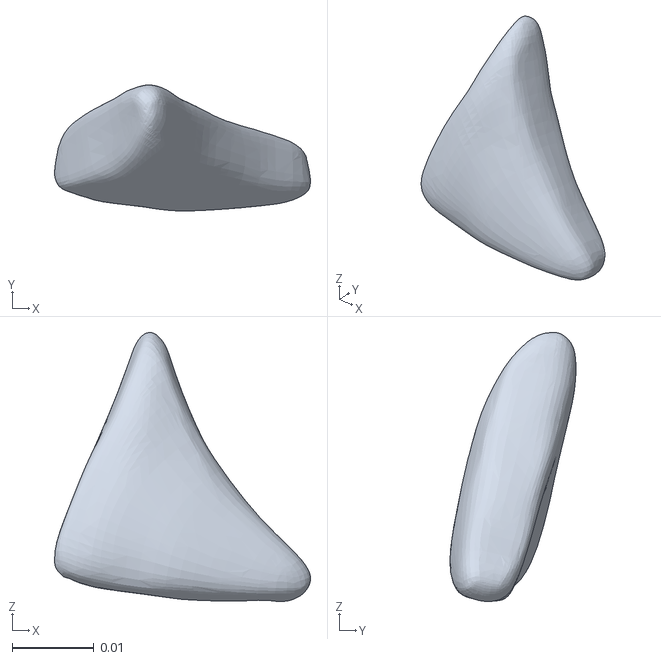
[picture p53: CAD file, 2026-10-26]
hand2/hand2_1/body/meshes/right/r_midpalm_cover.STL
0.0314 x 0.0154 x 0.033
