wuji-technology/wuji-description/hand2/hand2_2/body/meshes/left/l_pinky_proximal_abd_cover.STL

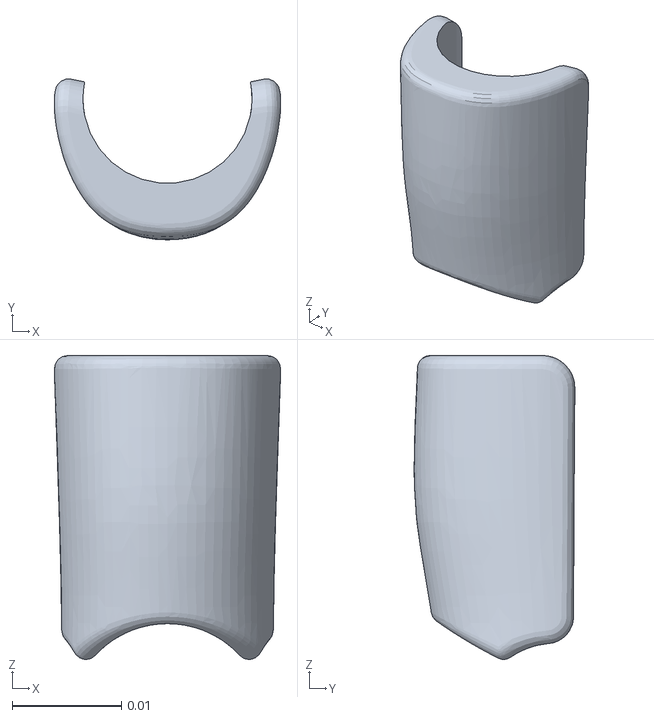
[picture p54: CAD file, 2026-10-26]
hand2/hand2_2/body/meshes/left/l_pinky_proximal_abd_cover.STL
0.0208 x 0.0147 x 0.0279
