wuji-technology/wuji-description/hand2/hand2_2/body/meshes/right/r_thumb_proximal.STL

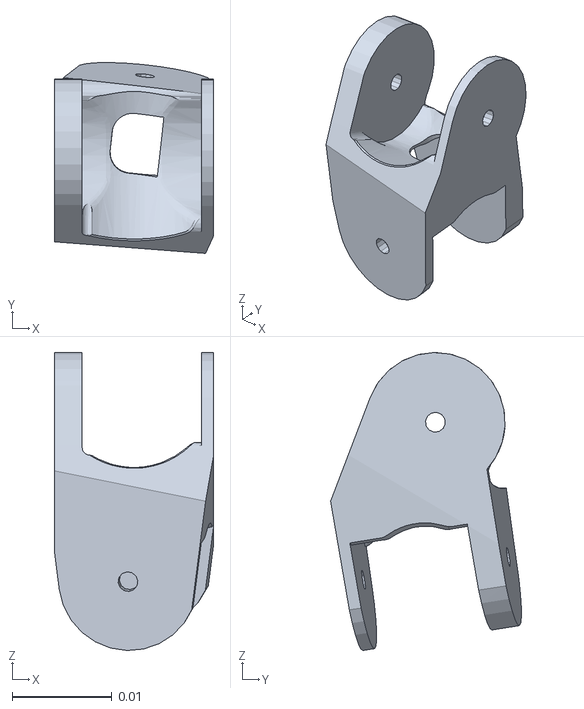
[picture p55: CAD file, 2026-10-12]
hand2/hand2_2/body/meshes/right/r_thumb_proximal.STL
0.016 x 0.0192 x 0.0299
