wuji-technology/wuji-description/hand2/hand2_1/body/meshes/right/r_pinky_proximal_cover.STL

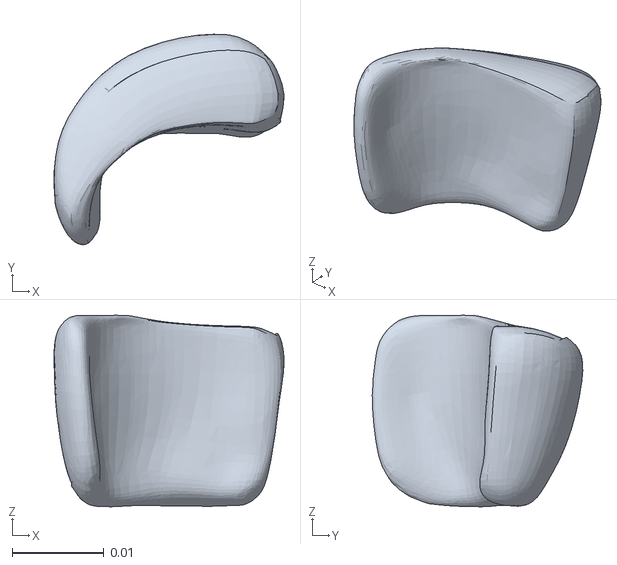
[picture p57: CAD file, 2026-10-26]
hand2/hand2_1/body/meshes/right/r_pinky_proximal_cover.STL
0.0251 x 0.023 x 0.0209
