wuji-technology/wuji-description/hand2/hand2_beta2/body/meshes/right/r_thumb_tip_sensor_frame.STL

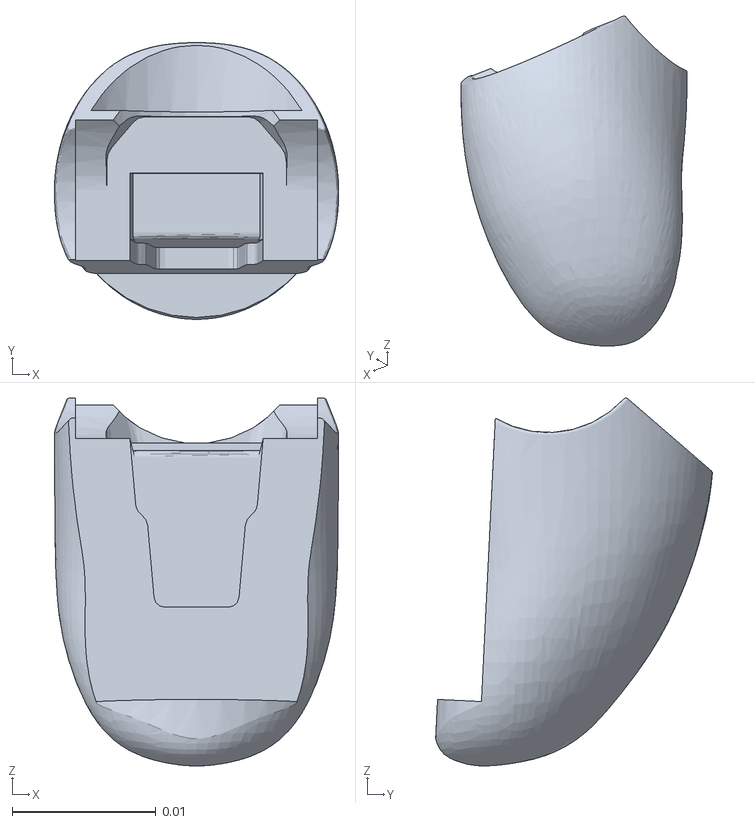
[picture p58: CAD file, 2026-08-14]
hand2/hand2_beta2/body/meshes/right/r_thumb_tip_sensor_frame.STL
0.0198 x 0.0192 x 0.0256
