wuji-technology/wuji-description/hand/body-with-soft/meshes/right/right_palm_link_simplified.STL

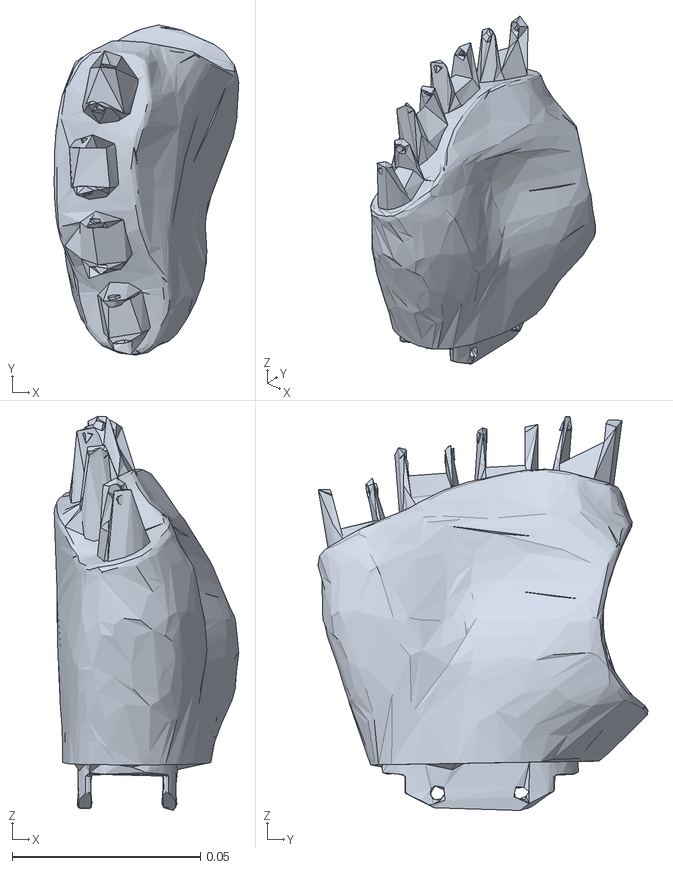
[picture p59: CAD file, 2026-06-10]
hand/body-with-soft/meshes/right/right_palm_link_simplified.STL
0.049 x 0.0876 x 0.105
