wuji-technology/wuji-description/hand2/hand2_2/body/meshes/left/l_ring_finger_proximal.STL

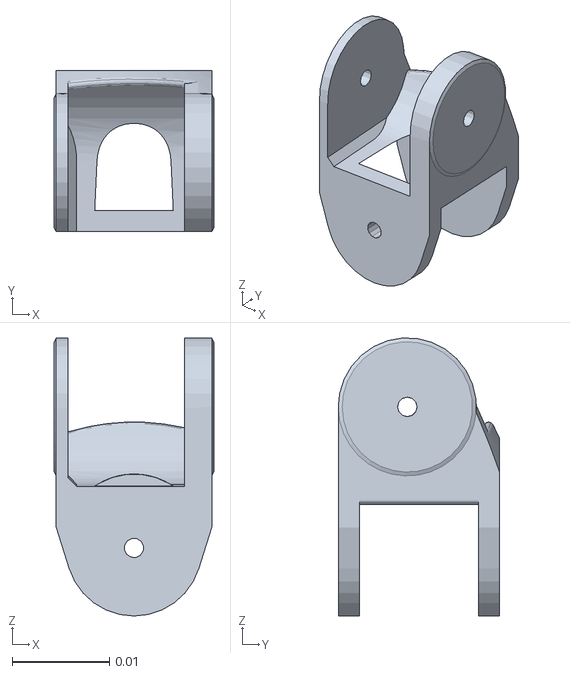
[picture p60: CAD file, 2026-10-12]
hand2/hand2_2/body/meshes/left/l_ring_finger_proximal.STL
0.0164 x 0.0166 x 0.0286
