wuji-technology/wuji-description/hand2/hand2_2/body/meshes/right/r_middle_finger_distal.STL

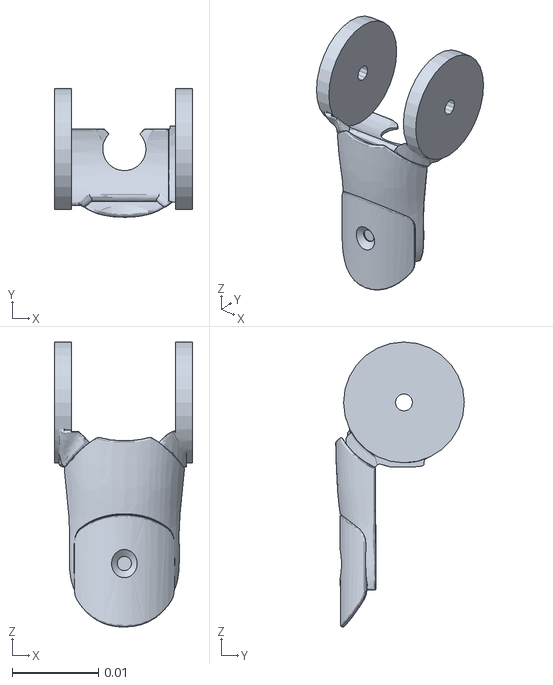
[picture p61: CAD file, 2026-10-12]
hand2/hand2_2/body/meshes/right/r_middle_finger_distal.STL
0.016 x 0.0149 x 0.033
