wuji-technology/wuji-description/hand2/hand2_beta1/body/meshes/right/r_thumb_middle.STL

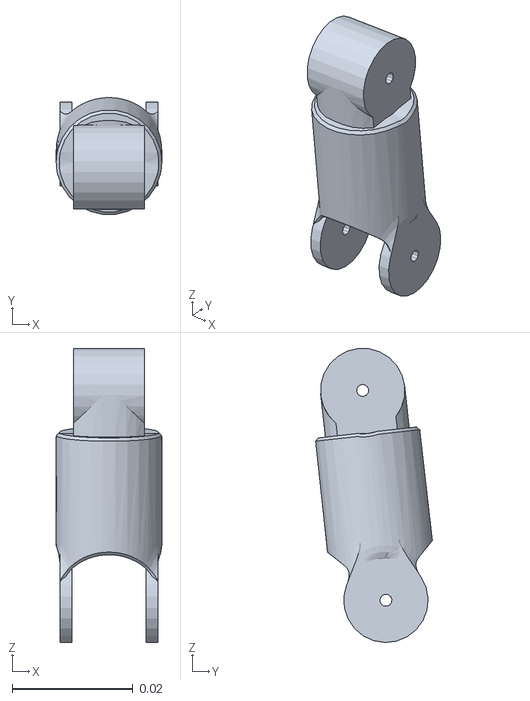
[picture p62: CAD file, 2026-07-23]
hand2/hand2_beta1/body/meshes/right/r_thumb_middle.STL
0.0175 x 0.0194 x 0.0487
