wuji-technology/wuji-description/hand2/hand2_beta2/body/meshes/left/l_thumb_distal.STL

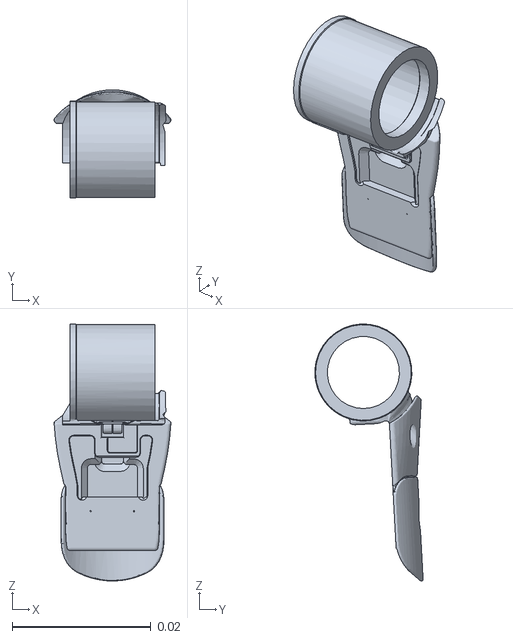
[picture p63: CAD file, 2026-08-14]
hand2/hand2_beta2/body/meshes/left/l_thumb_distal.STL
0.0169 x 0.0156 x 0.0371
