wuji-technology/wuji-description/hand/body-with-soft/meshes/left/left_finger5_link4.STL

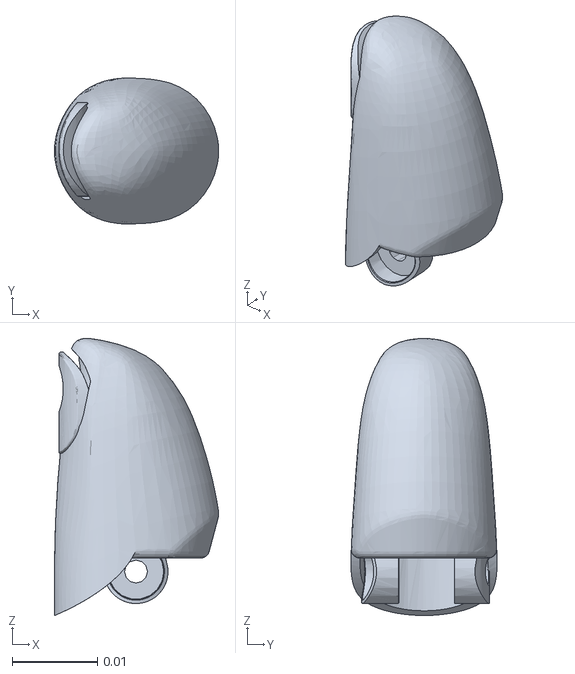
[picture p64: CAD file, 2026-06-10]
hand/body-with-soft/meshes/left/left_finger5_link4.STL
0.0193 x 0.0171 x 0.0325
