wuji-technology/wuji-description/hand/body-with-soft/meshes/right/right_finger3_link4_simplified.STL

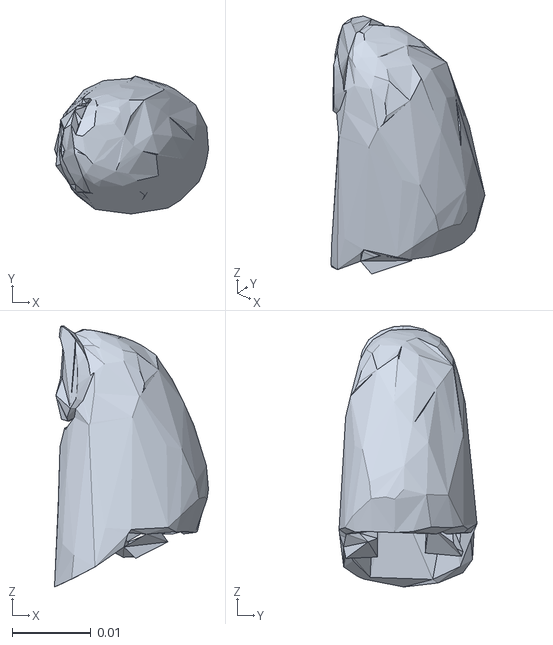
[picture p65: CAD file, 2026-06-10]
hand/body-with-soft/meshes/right/right_finger3_link4_simplified.STL
0.0195 x 0.0175 x 0.0331
