wuji-technology/wuji-description/hand2/hand2_2/body/meshes/left/l_thumb_tip_sensor_frame.STL

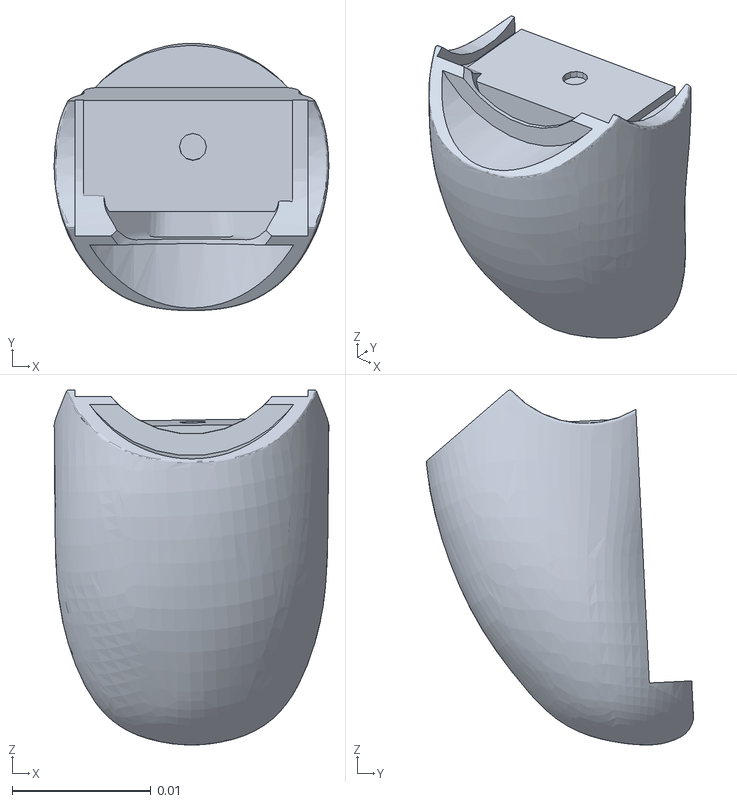
[picture p66: CAD file, 2026-10-12]
hand2/hand2_2/body/meshes/left/l_thumb_tip_sensor_frame.STL
0.0198 x 0.0192 x 0.0256
