wuji-technology/wuji-description/hand2/hand2_2/body/meshes/right/r_pinky_middle.STL

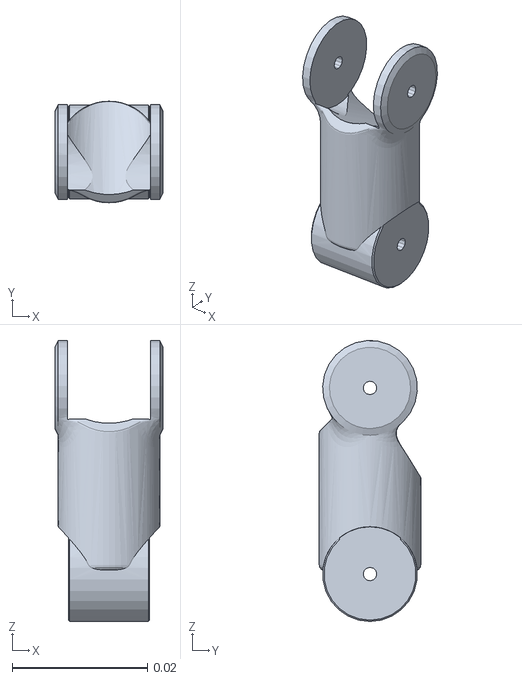
[picture p67: CAD file, 2026-10-12]
hand2/hand2_2/body/meshes/right/r_pinky_middle.STL
0.016 x 0.015 x 0.0415
