wuji-technology/wuji-description/hand2/hand2_beta2/body/meshes/right/r_thumb_middle.STL

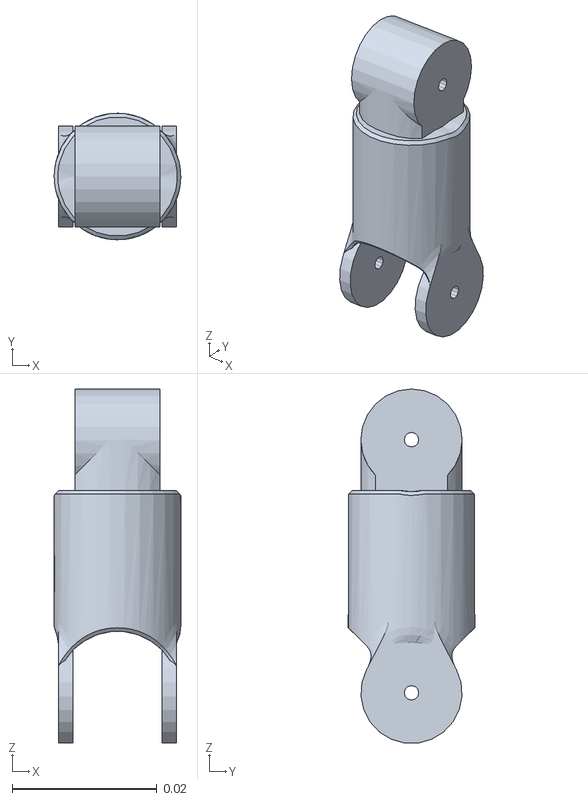
[picture p68: CAD file, 2026-08-14]
hand2/hand2_beta2/body/meshes/right/r_thumb_middle.STL
0.0175 x 0.0175 x 0.0489
