wuji-technology/wuji-description/hand/body-with-soft/meshes/left/left_finger1_link4_simplified.STL

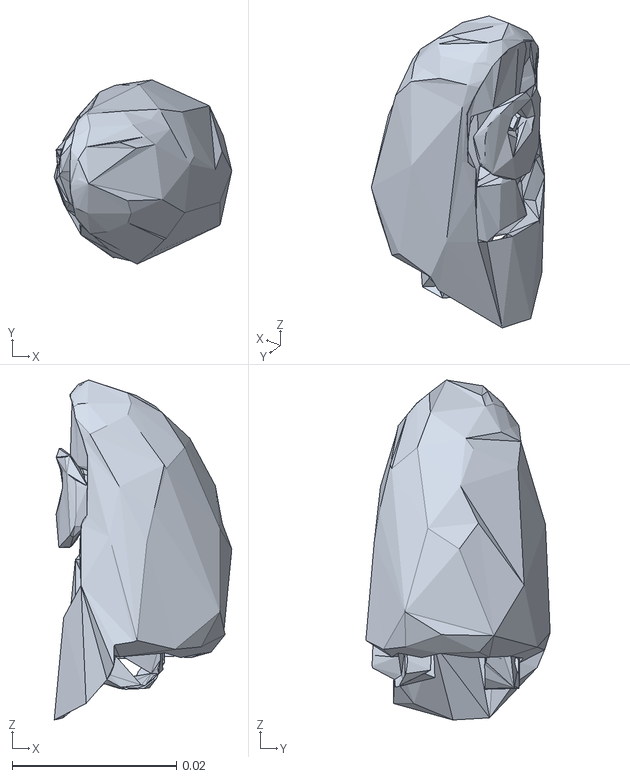
[picture p69: CAD file, 2026-06-10]
hand/body-with-soft/meshes/left/left_finger1_link4_simplified.STL
0.0216 x 0.0225 x 0.0414
