wuji-technology/wuji-description/hand2/hand2_1/body/meshes/right/r_thumb_middle.STL

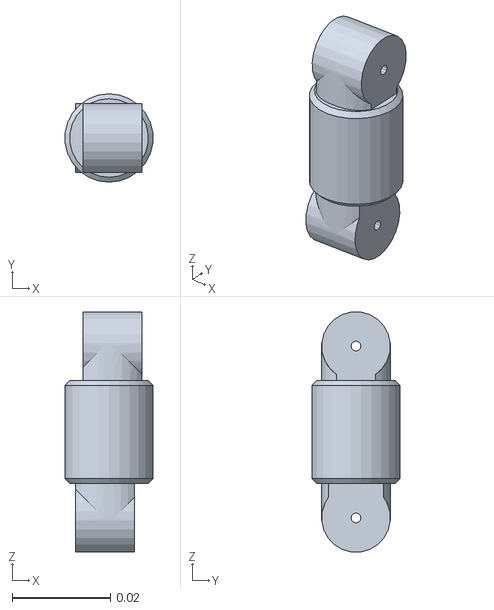
[picture p70: CAD file, 2026-10-12]
hand2/hand2_1/body/meshes/right/r_thumb_middle.STL
0.0179 x 0.018 x 0.0489
