wuji-technology/wuji-description/hand2/hand2_beta2/body/meshes/right/r_thumb_tip.STL

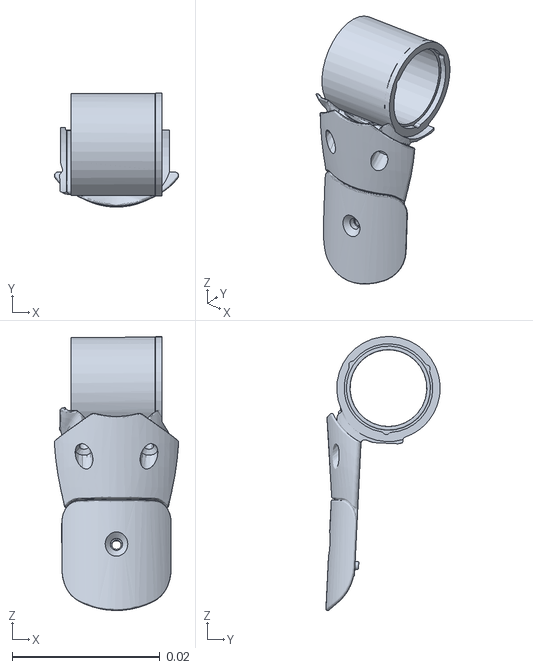
[picture p71: CAD file, 2026-08-14]
hand2/hand2_beta2/body/meshes/right/r_thumb_tip.STL
0.0169 x 0.0155 x 0.0371
