wuji-technology/wuji-description/hand/body-with-soft/meshes/left/left_finger3_link1.STL

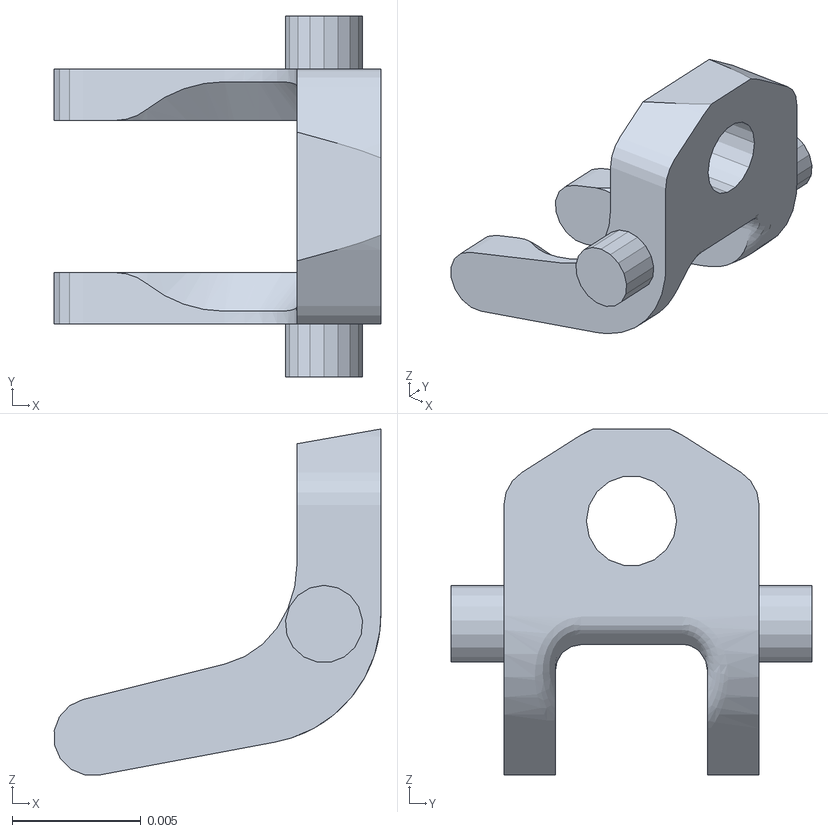
[picture p72: CAD file, 2026-06-10]
hand/body-with-soft/meshes/left/left_finger3_link1.STL
0.0127 x 0.014 x 0.0134
