wuji-technology/wuji-description/hand/body-with-soft/meshes/right/right_finger1_link4_simplified.STL

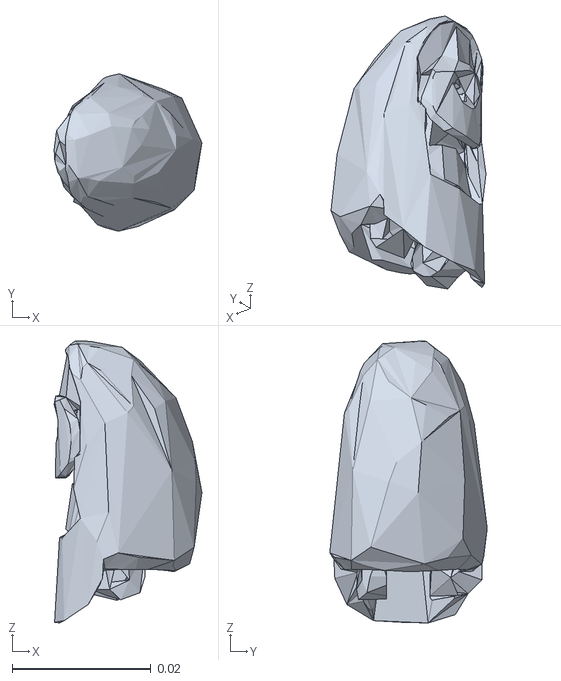
[picture p73: CAD file, 2026-06-10]
hand/body-with-soft/meshes/right/right_finger1_link4_simplified.STL
0.0213 x 0.0227 x 0.0407
