wuji-technology/wuji-description/(list of files, cad)

Other CAD files:
hand2/hand2_1/body/meshes/right/visual_nails/r_ring_finger_distal_black_remainder.STL
hand2/hand2_1/body/meshes/left/visual_nails/l_pinky_distal_black_remainder.STL
hand2/hand2_2/body/meshes/left/visual_nails/l_pinky_distal_black_remainder.STL
hand2/hand2_2/body/meshes/right/visual_nails/r_middle_finger_distal_black_remainder.STL
hand2/hand2_2/body/step/wuji-hand2-description-left_hand2_2_step.STEP
hand2/hand2_beta1/body/meshes/right/r_mount.STL
hand2/hand2_1/body/step/wuji-hand2-description-right_hand2_1_step.STEP
hand2/hand2_beta1/body/meshes/right/r_middle_finger_distal.STL
hand/body-with-soft/meshes/right/right_finger4_link2.STL
hand2/hand2_1/body/meshes/left/l_index_finger_middle.STL
hand2/hand2_1/body/meshes/left/visual_nails/l_pinky_distal_nail_cap.STL
hand2/hand2_1/body/meshes/right/r_index_finger_proximal_abd_cover.STL
hand2/hand2_2/body/meshes/left/l_middle_finger_proximal_abd_cover.STL
hand2/hand2_2/body/meshes/right/r_palm_middle_cover.STL
hand2/hand2_beta1/body/meshes/left/l_pinky_distal.STL
hand2/hand2_beta1/body/meshes/right/r_index_finger_distal.STL
hand2/hand2_beta2/body/meshes/right/r_index_finger_distal.STL
hand/body-with-soft/meshes/left/left_finger5_link3.STL
hand2/hand2_1/body/meshes/right/r_middle_finger_proximal_abd_cover.STL
hand2/hand2_beta1/body/meshes/right/r_index_finger_proximal_abd.STL
hand2/hand2_beta2/body/meshes/left/l_middle_finger_tip.STL
hand2/hand2_beta2/body/meshes/right/r_pinky_tip_sensor_frame.STL
hand2/hand2_1/body/meshes/left/l_middle_finger_proximal_abd.STL
hand2/hand2_2/body/meshes/left/l_palm_ring_cover.STL
hand2/hand2_2/body/meshes/right/r_pinky_middle_cover.STL
hand2/hand2_beta1/body/meshes/left/l_middle_finger_proximal_abd.STL
hand2/hand2_beta2/body/meshes/left/l_pinky_tip.STL
hand2/hand2_beta2/body/meshes/right/r_ring_finger_tip_sensor_frame.STL
hand/body-with-soft/meshes/left/left_finger1_link2_softbody.STL
hand2/hand2_beta1/body/meshes/left/l_middle_finger_distal.STL
hand2/hand2_beta1/body/meshes/right/r_thumb_tip.STL
hand2/hand2_beta2/body/meshes/left/l_ring_finger_distal.STL
hand2/hand2_beta2/body/meshes/right/r_mount.STL
hand/body-with-soft/meshes/right/right_finger3_link4.STL
hand2/hand2_1/body/meshes/left/l_middle_finger_tip.STL
hand2/hand2_2/body/meshes/left/l_index_finger_tip.STL
hand2/hand2_2/body/meshes/right/r_mount.STL
hand2/hand2_beta1/body/meshes/left/l_ring_finger_tip.STL
hand2/hand2_beta1/body/meshes/right/r_index_finger_tip.STL
hand2/hand2_beta2/body/meshes/left/l_ring_finger_proximal.STL
hand/body-with-soft/meshes/left/left_finger3_link4.STL
hand2/hand2_1/body/meshes/left/l_mount.STL
hand2/hand2_1/body/meshes/right/r_middle_finger_distal.STL
hand2/hand2_beta1/body/meshes/left/l_ring_finger_proximal.STL
hand2/hand2_beta2/body/meshes/right/r_pinky_distal.STL
hand2/hand2_1/body/meshes/right/r_index_finger_tip.STL
hand2/hand2_2/body/meshes/right/r_middle_finger_tip.STL
hand2/hand2_beta1/body/meshes/left/l_middle_finger_tip.STL
hand2/hand2_beta1/body/meshes/right/r_middle_finger_proximal.STL
hand2/hand2_beta2/body/meshes/left/l_index_finger_distal.STL
hand2/hand2_beta2/body/meshes/right/r_index_finger_proximal.STL
hand/body-with-soft/meshes/left/left_finger4_link2.STL
hand/body-with-soft/meshes/right/right_finger2_link2.STL
hand2/hand2_1/body/meshes/right/r_index_finger_proximal_abd.STL
hand2/hand2_2/body/meshes/left/l_middle_finger_middle.STL
hand2/hand2_beta1/body/meshes/left/l_index_finger_middle.STL
hand2/hand2_beta1/body/meshes/right/r_index_finger_proximal.STL
hand/body-with-soft/meshes/right/right_finger4_tip_link.STL
hand2/hand2_1/body/meshes/right/r_ring_finger_middle.STL
hand2/hand2_2/body/meshes/left/l_ring_finger_distal.STL
hand2/hand2_2/body/meshes/right/r_ring_finger_proximal_abd.STL
hand2/hand2_beta1/body/meshes/left/l_pinky_tip.STL
hand2/hand2_beta1/body/meshes/right/r_ring_finger_proximal_abd.STL
hand2/hand2_beta2/body/meshes/right/r_middle_finger_middle.STL
hand/body-with-soft/meshes/left/left_finger2_tip_link.STL
hand/body-with-soft/meshes/right/right_finger3_link3.STL
hand2/hand2_2/body/meshes/left/l_thumb_tip.STL
hand2/hand2_2/body/meshes/right/r_ring_finger_tip.STL
hand2/hand2_beta1/body/meshes/left/l_index_finger_proximal_abd.STL
hand2/hand2_beta1/body/meshes/right/r_index_finger_middle.STL
hand2/hand2_beta2/body/meshes/left/l_middle_finger_proximal.STL
hand2/hand2_2/body/meshes/right/r_pinky_distal.STL
hand2/hand2_beta1/body/meshes/left/l_index_finger_tip.STL
hand/body-with-soft/meshes/left/left_finger1_link1.STL
hand/body-with-soft/meshes/left/left_finger1_link2.STL
hand/body-with-soft/meshes/left/left_finger1_link2_softbody_simplified.STL
hand/body-with-soft/meshes/left/left_finger1_link3.STL
hand/body-with-soft/meshes/left/left_finger1_link4.STL
hand/body-with-soft/meshes/left/left_finger2_link1.STL
hand/body-with-soft/meshes/left/left_finger2_link3.STL
hand/body-with-soft/meshes/left/left_finger2_link4_simplified.STL
hand/body-with-soft/meshes/left/left_finger3_link2.STL
hand/body-with-soft/meshes/left/left_finger3_link3.STL
hand/body-with-soft/meshes/left/left_finger3_link4_simplified.STL
hand/body-with-soft/meshes/left/left_finger3_tip_link.STL
hand/body-with-soft/meshes/left/left_finger4_link1.STL
hand/body-with-soft/meshes/left/left_finger4_link4.STL
hand/body-with-soft/meshes/left/left_finger4_link4_simplified.STL
hand/body-with-soft/meshes/left/left_finger4_tip_link.STL
hand/body-with-soft/meshes/left/left_finger5_link1.STL
hand/body-with-soft/meshes/left/left_finger5_link2.STL
hand/body-with-soft/meshes/left/left_finger5_tip_link.STL
hand/body-with-soft/meshes/left/left_palm_link.STL
hand/body-with-soft/meshes/left/left_palm_link_simplified.STL
hand/body-with-soft/meshes/right/right_finger1_link1.STL
hand/body-with-soft/meshes/right/right_finger1_link2.STL
hand/body-with-soft/meshes/right/right_finger1_link2_softbody.STL
hand/body-with-soft/meshes/right/right_finger1_link4.STL
hand/body-with-soft/meshes/right/right_finger1_tip_link.STL
hand/body-with-soft/meshes/right/right_finger2_link1.STL
hand/body-with-soft/meshes/right/right_finger2_link3.STL
hand/body-with-soft/meshes/right/right_finger2_link4.STL
hand/body-with-soft/meshes/right/right_finger2_link4_simplified.STL
hand/body-with-soft/meshes/right/right_finger2_tip_link.STL
hand/body-with-soft/meshes/right/right_finger3_link1.STL
hand/body-with-soft/meshes/right/right_finger3_link2.STL
hand/body-with-soft/meshes/right/right_finger3_tip_link.STL
hand/body-with-soft/meshes/right/right_finger4_link1.STL
hand/body-with-soft/meshes/right/right_finger4_link3.STL
hand/body-with-soft/meshes/right/right_finger4_link4.STL
hand/body-with-soft/meshes/right/right_finger5_link1.STL
hand/body-with-soft/meshes/right/right_finger5_link2.STL
hand/body-with-soft/meshes/right/right_finger5_link4.STL
hand/body-with-soft/meshes/right/right_finger5_link4_simplified.STL
hand/body-with-soft/meshes/right/right_finger5_tip_link.STL
hand/body/meshes/left/left_finger1_link1.STL
hand/body/meshes/left/left_finger1_link2.STL
hand/body/meshes/left/left_finger1_link3.STL
hand/body/meshes/left/left_finger1_link4.STL
hand/body/meshes/left/left_finger1_tip_link.STL
hand/body/meshes/left/left_finger2_link1.STL
hand/body/meshes/left/left_finger2_link2.STL
hand/body/meshes/left/left_finger2_link3.STL
hand/body/meshes/left/left_finger2_link4.STL
hand/body/meshes/left/left_finger2_tip_link.STL
hand/body/meshes/left/left_finger3_link1.STL
hand/body/meshes/left/left_finger3_link2.STL
hand/body/meshes/left/left_finger3_link3.STL
hand/body/meshes/left/left_finger3_link4.STL
hand/body/meshes/left/left_finger3_tip_link.STL
hand/body/meshes/left/left_finger4_link1.STL
hand/body/meshes/left/left_finger4_link2.STL
hand/body/meshes/left/left_finger4_link3.STL
hand/body/meshes/left/left_finger4_link4.STL
hand/body/meshes/left/left_finger4_tip_link.STL
hand/body/meshes/left/left_finger5_link1.STL
hand/body/meshes/left/left_finger5_link2.STL
hand/body/meshes/left/left_finger5_link3.STL
hand/body/meshes/left/left_finger5_link4.STL
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
