wuji-technology/wuji-description/hand2/hand2_1/body/mjcf/left.xml

<mujoco model="wujihand2_1-left">
  <compiler angle="radian" meshdir="../meshes/left/" />
  <option jacobian="sparse" integrator="RK4" timestep="0.002" solver="Newton" iterations="50" tolerance="1e-10" />
  <default>
    <joint armature="0.0002" damping="0.0" />
  </default>
  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
  <worldbody>
    <body name="l_mount">
      <inertial pos="-0.0028522763392 0.00108479281306 -0.0169637652923" mass="0.069" quat="0.06068677 0.83355757 -0.18140747 -0.51825691" diaginertia="2.60473092e-05 2.50880832e-05 1.69284673e-05" />
      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
      <body name="l_wrist" pos="0.00300066278665 0 -0.0285015084627" quat="1 0 0 -8.16917936e-06">
        <inertial pos="-0.00231818979509 0.00322549328424 -0.036414568905" mass="0.2323" quat="-0.68484107 -0.15427429 0.08933392 0.70654908" diaginertia="1.49960227e-04 9.35661525e-05 7.76782770e-05" />
        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
        <body name="l_thumb_proximal" pos="0.0177341751 -0.00843768025 -0.0158889915" quat="0.617674343 0.0652633672 -0.730220488 -0.284599962">
          <inertial pos="-0.000478235 0.000999068 -0.00724395" quat="0.963902 -0.0810547 -0.21386 -0.136334" mass="0.011" diaginertia="8.28216e-07 7.7349e-07 6.26397e-07" />
          <joint name="l_thumb_cmc_flex" pos="0 0 0" axis="-1 0 0" range="-1.187 1.291" actuatorfrcrange="-0.6 0.6" armature="0.0005" />
          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
          <body name="l_thumb_proximal_abd" pos="0.000247878 0.000536583 -0.0147535" quat="0.934711 -0.0919298 0.342518 0.023367">
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
            <joint name="l_pinky_mcp_abd" pos="0 0 0" axis="0 1 0" range="-0.698 0.698" actuatorfrcrange="-0.2 0.2" />
            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
            <body name="l_pinky_middle" pos="0 0 -0.0336">
              <inertial pos="-2.8724e-08 0.000264301 -0.0178856" quat="0.707256 -0.0112957 0.0112711 0.706777" mass="0.0188" diaginertia="2.05981e-06 1.98682e-06 5.85023e-07" />
              <joint name="l_pinky_pip" pos="0 0 0" axis="-1 0 0" range="-1.047 2.094" actuatorfrcrange="-0.3 0.3" />
              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
              <body name="l_pinky_distal" pos="0 0 -0.0275">
                <inertial pos="1.82235e-05 0.000718558 -0.0118158" quat="0.700693 0.0392557 -0.0412444 0.711187" mass="0.0078" diaginertia="5.71318e-07 5.31417e-07 2.7055e-07" />
                <joint name="l_pinky_dip" pos="0 0 0" axis="-1 0 0" range="-1.047 1.57" actuatorfrcrange="-0.3 0.3" />
                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
              </body>
            </body>
          </body>
        </body>
        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
      </body>
    </body>
  </worldbody>
  <actuator>
    <position name="l_THJ0" joint="l_thumb_cmc_flex" kp="0.40844710645048043" kv="0.020882010257063675" ctrlrange="-1.187 1.291" forcerange="-0.6 0.6" />
    <position name="l_THJ1" joint="l_thumb_cmc_abd" kp="0.6858601063643346" kv="0.030610939996373314" ctrlrange="-1.484 0.698" forcerange="-0.6 0.6" />
    <position name="l_THJ2" joint="l_thumb_mcp" kp="0.2391112196099482" kv="0.010181475050560962" ctrlrange="-1.047 1.57" forcerange="-0.3 0.3" />
    <position name="l_THJ3" joint="l_thumb_ip" kp="0.20736128319711747" kv="0.00909698844675045" ctrlrange="-1.047 1.57" forcerange="-0.3 0.3" />
    <position name="l_FFJ0" joint="l_index_finger_mcp_flex" kp="0.37352218155860073" kv="0.01882274330029718" ctrlrange="-1.047 1.57" forcerange="-2 2" />
    <position name="l_FFJ1" joint="l_index_finger_mcp_abd" kp="0.45592448909027794" kv="0.019798167597016643" ctrlrange="-0.698 0.698" forcerange="-0.2 0.2" />
    <position name="l_FFJ2" joint="l_index_finger_pip" kp="0.24368366649522863" kv="0.010477031953162727" ctrlrange="-1.047 2.094" forcerange="-0.3 0.3" />
    <position name="l_FFJ3" joint="l_index_finger_dip" kp="0.18026971340925335" kv="0.008240212147903584" ctrlrange="-1.047 1.57" forcerange="-0.3 0.3" />
    <position name="l_MFJ0" joint="l_middle_finger_mcp_flex" kp="0.3687093483646485" kv="0.01848622487024593" ctrlrange="-1.047 1.57" forcerange="-2 2" />
    <position name="l_MFJ1" joint="l_middle_finger_mcp_abd" kp="0.4164253443634641" kv="0.018032947229953678" ctrlrange="-0.698 0.698" forcerange="-0.2 0.2" />
    <position name="l_MFJ2" joint="l_middle_finger_pip" kp="0.22218607502059182" kv="0.009592200014076666" ctrlrange="-1.047 2.094" forcerange="-0.3 0.3" />
    <position name="l_MFJ3" joint="l_middle_finger_dip" kp="0.19427606072023446" kv="0.009152994605972402" ctrlrange="-1.047 1.57" forcerange="-0.3 0.3" />
    <position name="l_RFJ0" joint="l_ring_finger_mcp_flex" kp="0.35718151495111794" kv="0.018376606800780005" ctrlrange="-1.047 1.57" forcerange="-2 2" />
    <position name="l_RFJ1" joint="l_ring_finger_mcp_abd" kp="0.42977315313086895" kv="0.01867700966212433" ctrlrange="-0.698 0.698" forcerange="-0.2 0.2" />
    <position name="l_RFJ2" joint="l_ring_finger_pip" kp="0.24930151196247122" kv="0.01059512121009555" ctrlrange="-1.047 2.094" forcerange="-0.3 0.3" />
    <position name="l_RFJ3" joint="l_ring_finger_dip" kp="0.2285032688178066" kv="0.009917602877441107" ctrlrange="-1.047 1.57" forcerange="-0.3 0.3" />
    <position name="l_LFJ0" joint="l_pinky_mcp_flex" kp="0.3655325975433942" kv="0.018616960278988272" ctrlrange="-1.047 1.57" forcerange="-2 2" />
    <position name="l_LFJ1" joint="l_pinky_mcp_abd" kp="0.41393113081120425" kv="0.018732177029667153" ctrlrange="-0.698 0.698" forcerange="-0.2 0.2" />
    <position name="l_LFJ2" joint="l_pinky_pip" kp="0.22729367621965954" kv="0.00951005441616486" ctrlrange="-1.047 2.094" forcerange="-0.3 0.3" />
    <position name="l_LFJ3" joint="l_pinky_dip" kp="0.1964723550341816" kv="0.009017295241756363" ctrlrange="-1.047 1.57" forcerange="-0.3 0.3" />
  </actuator>
  <sensor>
    <accelerometer name="l_wrist_imu_acc" site="l_wrist_imu_frame" />
    <gyro name="l_wrist_imu_gyro" site="l_wrist_imu_frame" />
  </sensor>
  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
</mujoco>
