wuji-technology/wuji-description/hand/attachment/wuji-hand-rl-open-source-base/Assembly.pdf

1 | 2 | 3 | 4

A

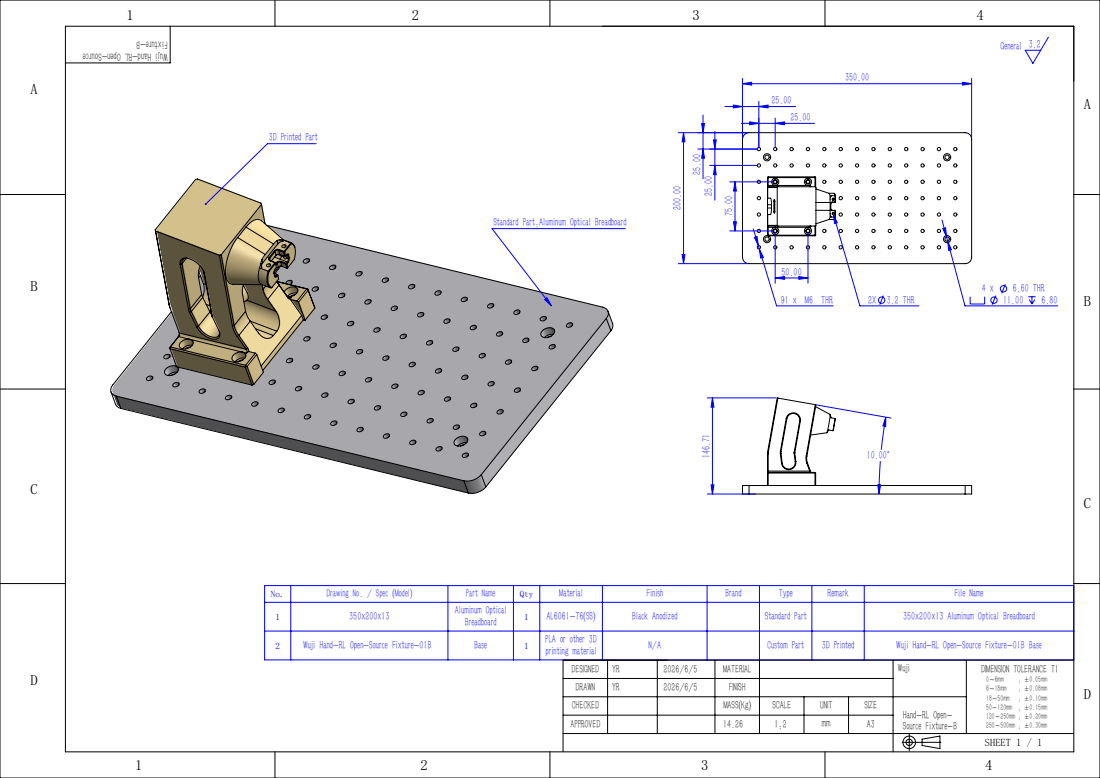
[picture p74: page 1]
3D Printed Part; 6.60 THR; 91 x M6 THR; 2X 3.2 THR; General 3.2

Standard Part:Aluminum Optical Breadboard

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

DESIGNED | YR | 2026/6/5 | MATERIAL | | Wuji | DIMENSION TOLERANCE T1 0～6mm ：±0.05mm 6～18mm ：±0.08mm 18～50mm ：±0.10mm 50～120mm ：±0.15mm 120～250mm ：±0.20mm 250～500mm ：±0.30mm
DRAWN | YR | 2026/6/5 | FINISH
CHECKED | | | MASS(Kg) | SCALE | UNIT | SIZE | Hand-RL Open-Source Fixture-B
APPROVED | | | 14.26 | 1:2 | mm | A3

SHEET 1 / 1
