wuji-technology/wuji-description/hand/attachment/step/wuji-hand&Impact-Resistant-Adapter-assembled-v1.pdf

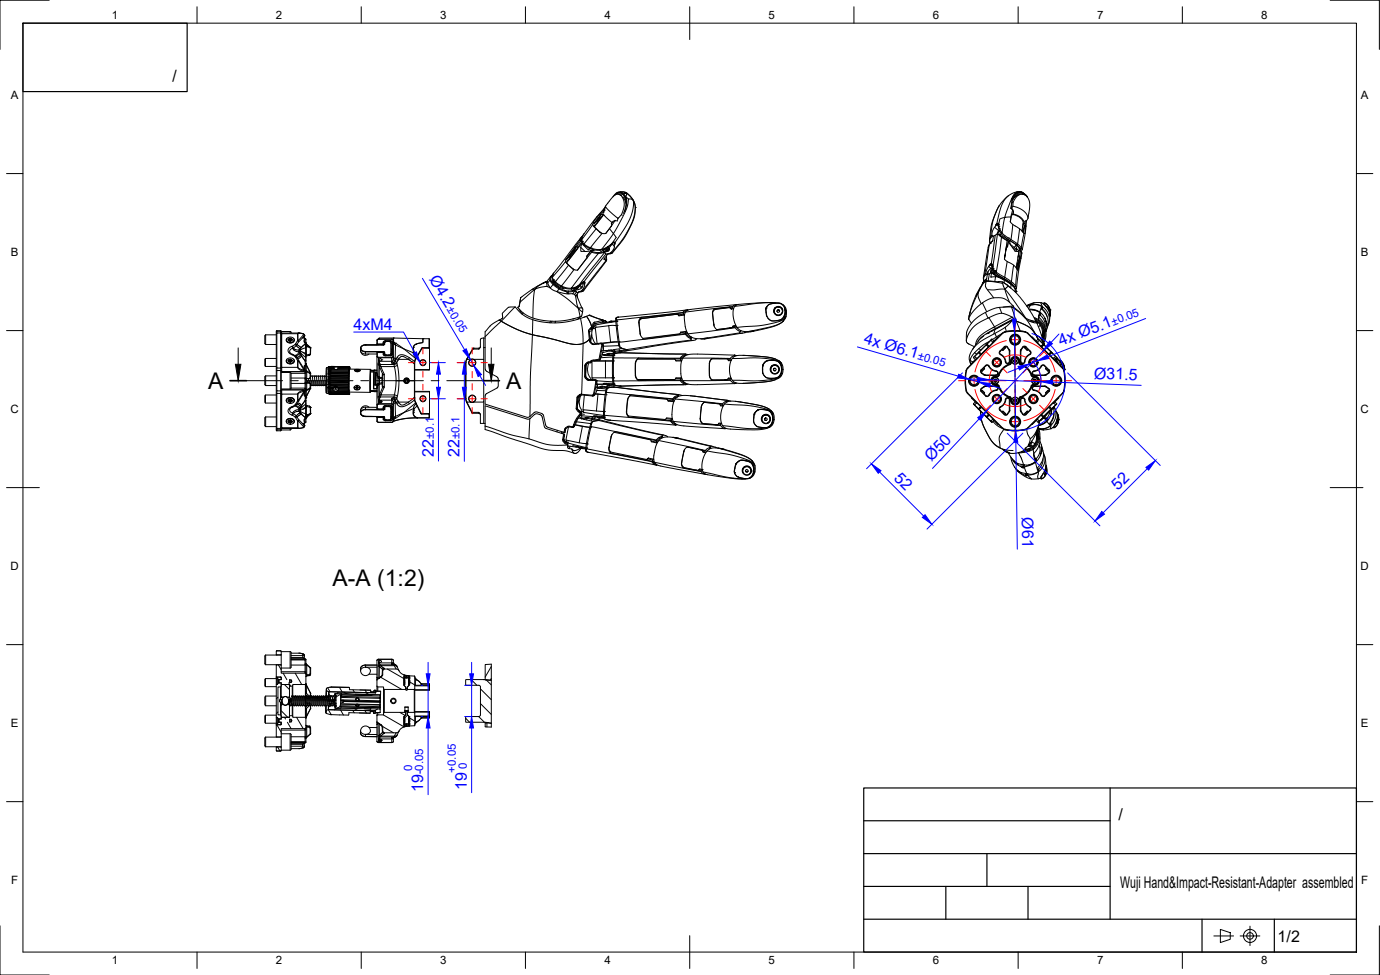
[picture p75: page 1]

Wuji Hand&Impact-Resistant-Adapter assembled

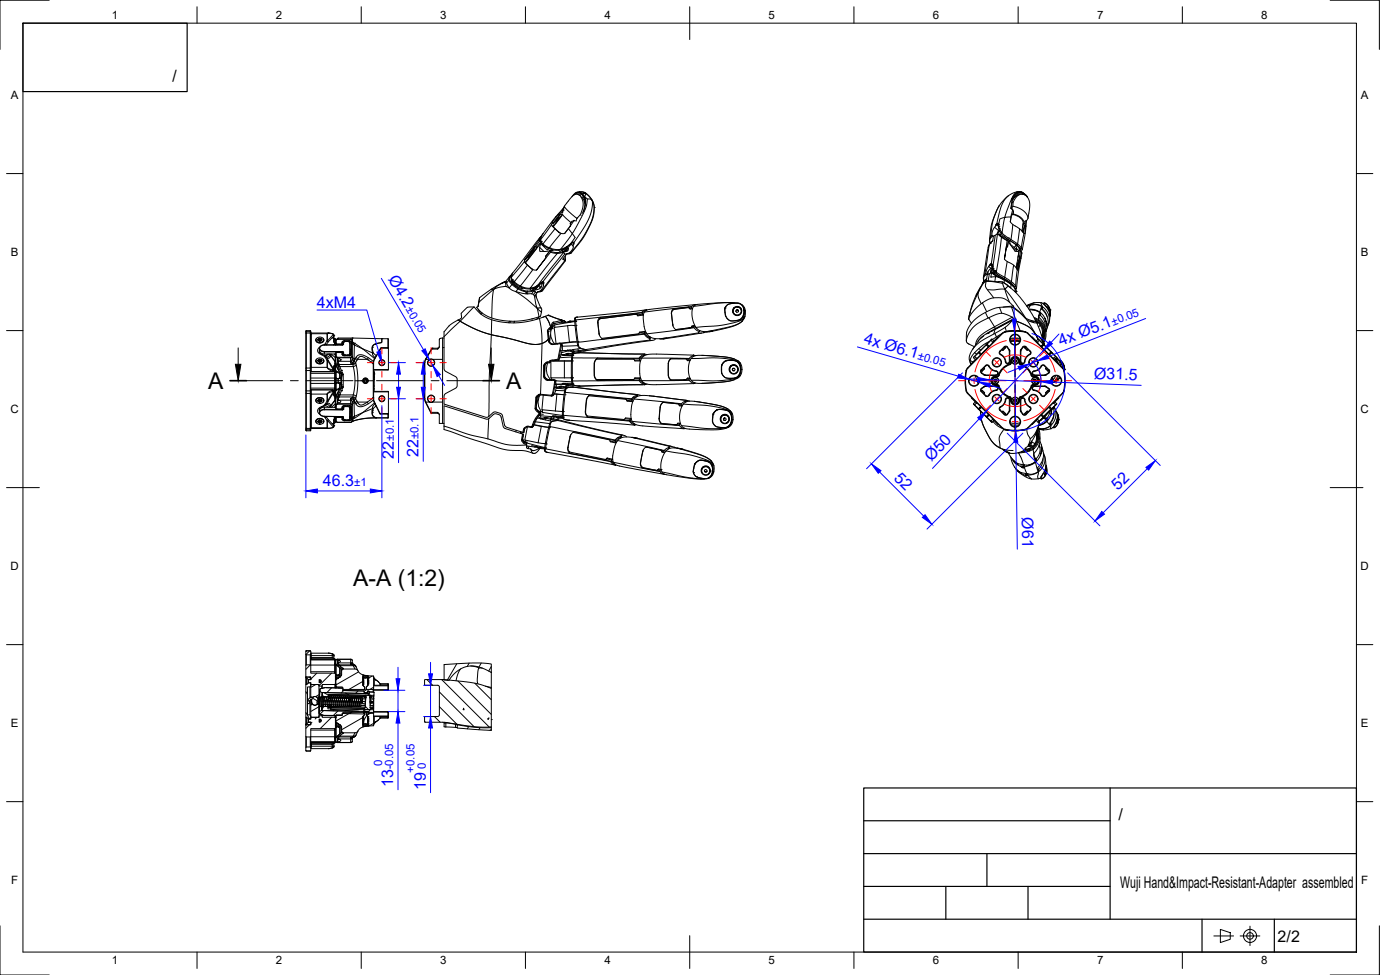
[picture p76: page 2]

Wuji Hand&Impact-Resistant-Adapter assembled
