wuji-technology/wuji-description/hand2/hand2_1/attachment/wuji-hand2-description-left-adapter_hand2_1.pdf

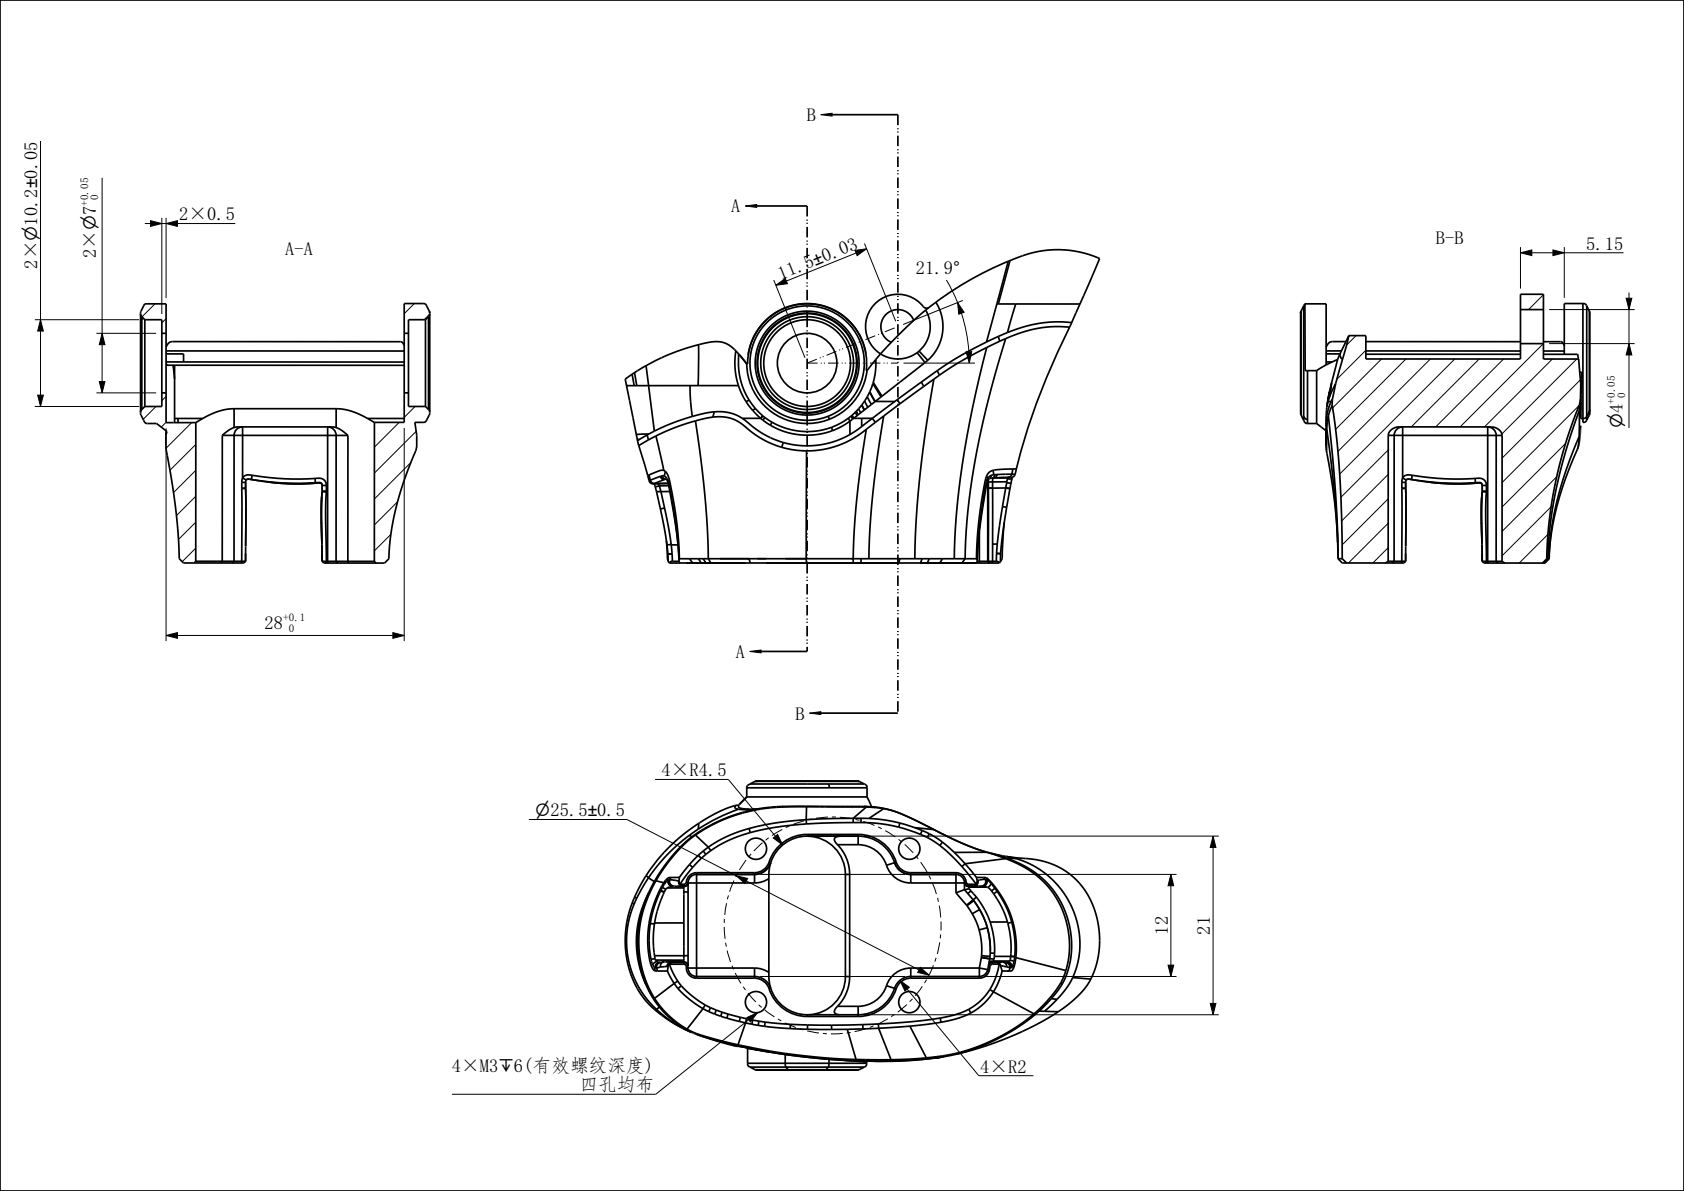
[picture p77: page 1]
