wuji-technology/wuji-description/hand2/hand2_1/attachment/wuji-hand2-description-right-adapter_hand2_1.pdf

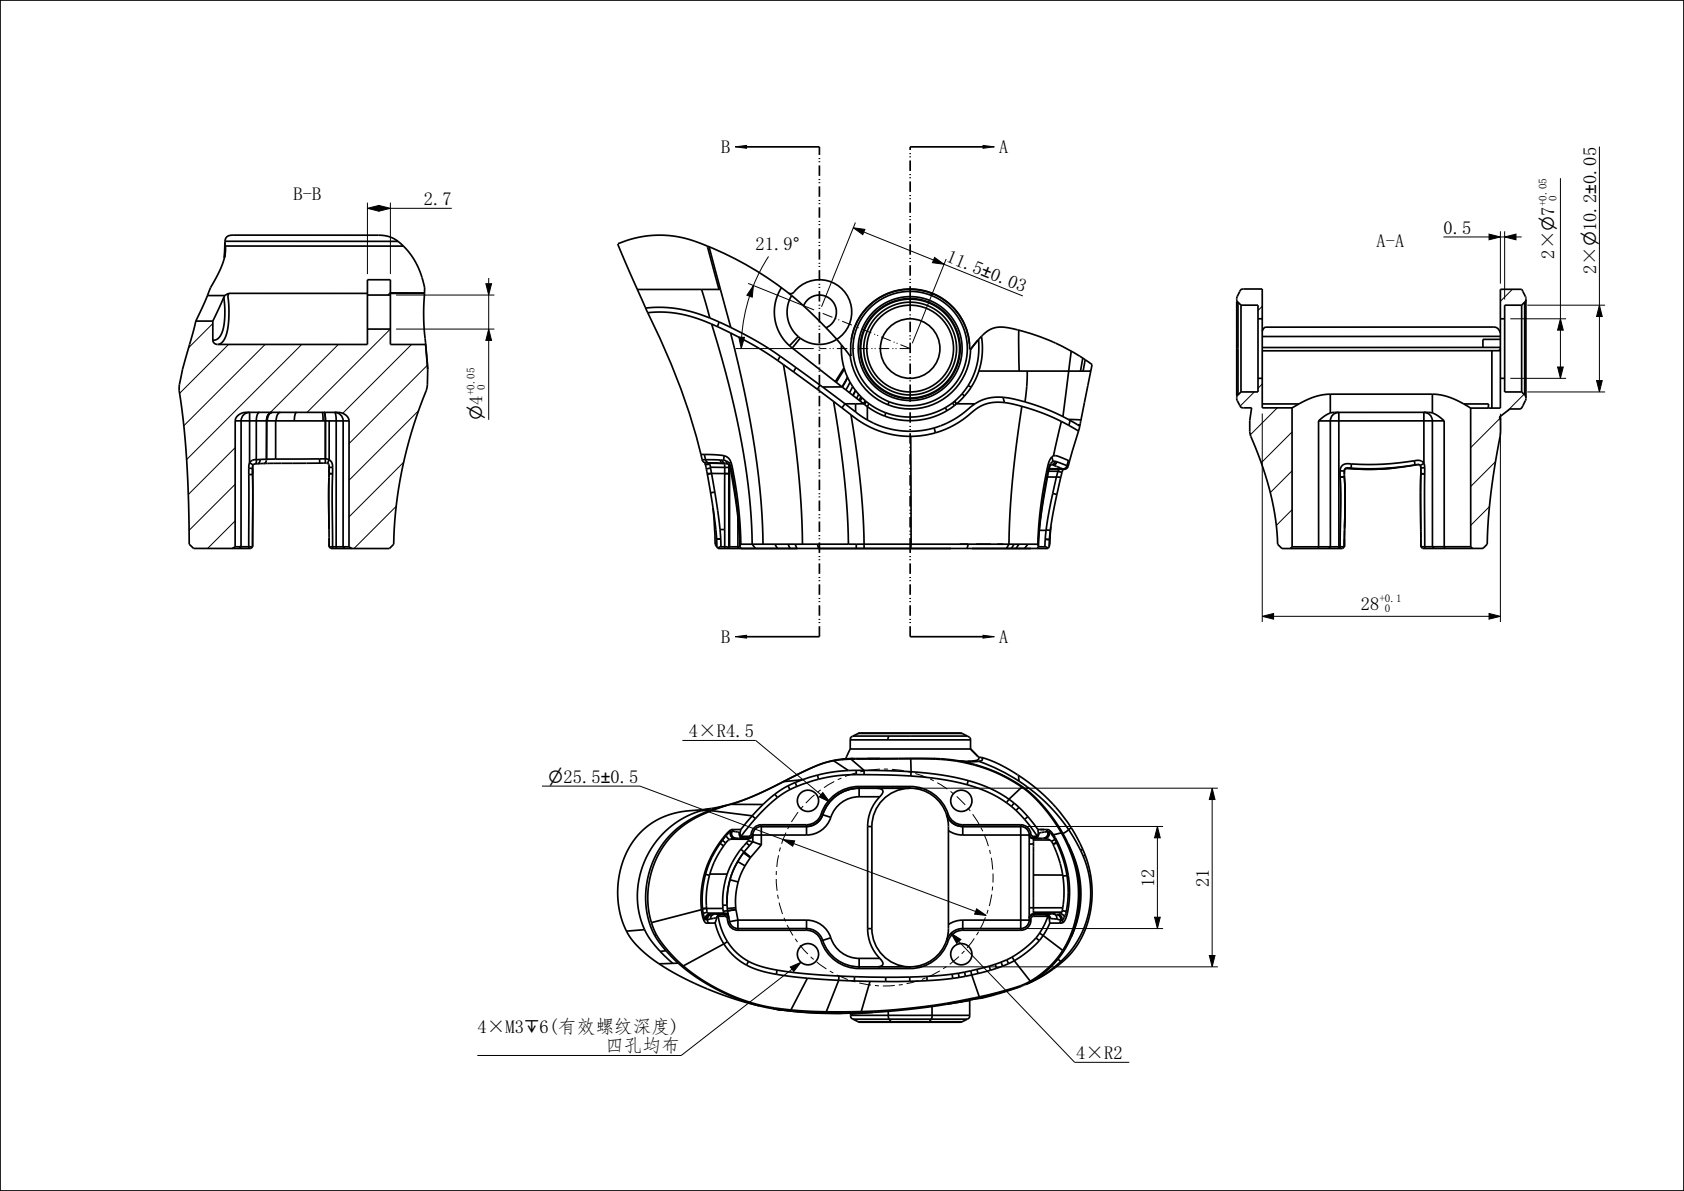
[picture p78: page 1]
