wuji-technology/wuji-description/hand2/hand2_2/attachment/wuji-hand2-description-adapter-flange_hand2_2.pdf

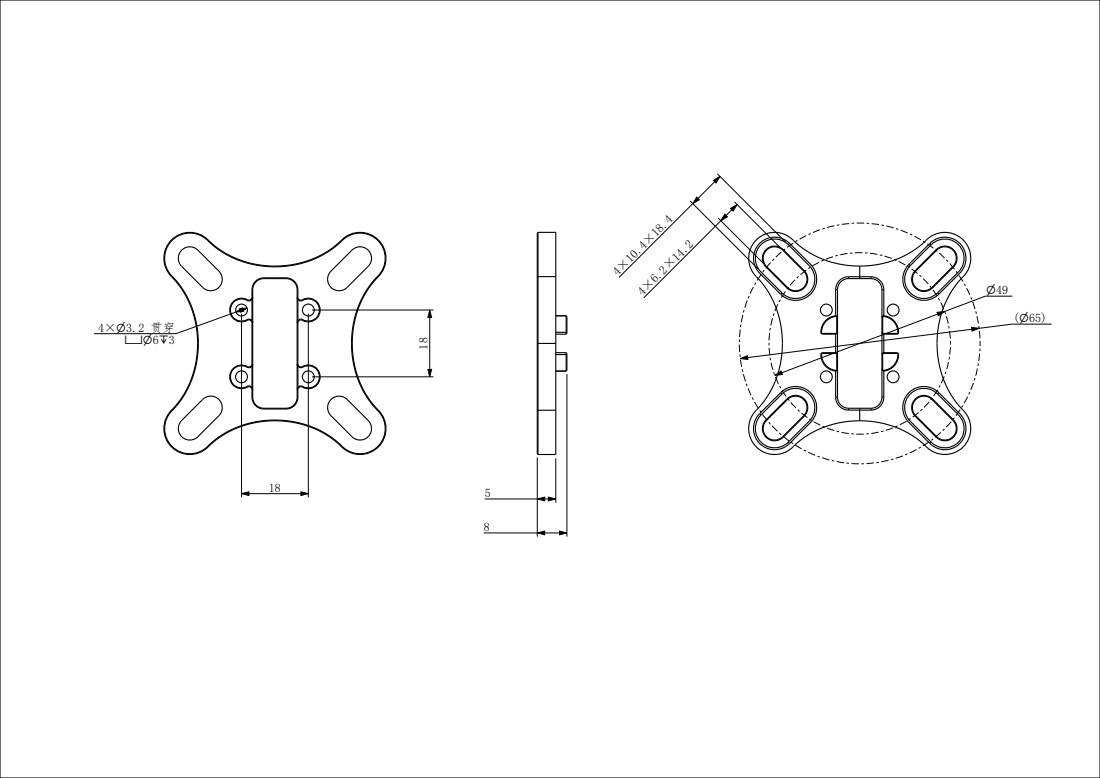
[picture p79: page 1]
