wuji-technology/wuji-description/hand2/hand2_2/attachment/wuji-hand2-description-left-mount_hand2_2.pdf

E | E
F | F

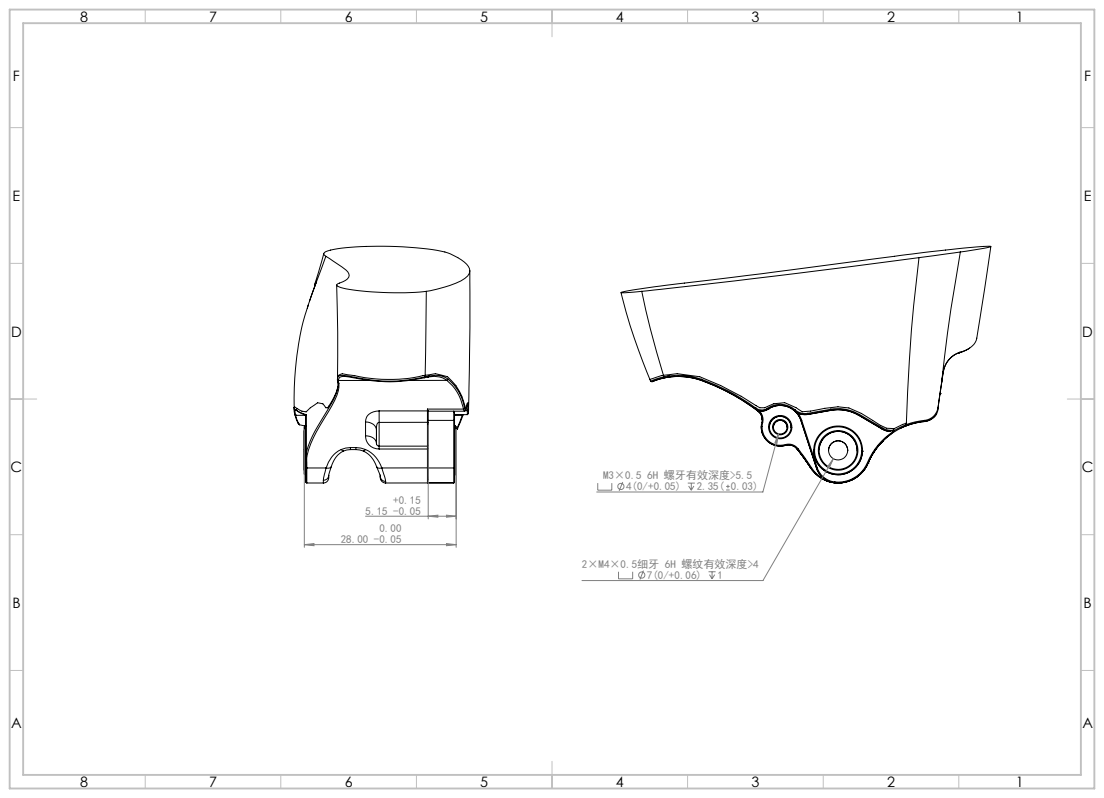
[picture p80: page 1]
2×M4×0.5细牙 6H 螺纹有效深度>4; M3×0.5 6H 螺牙有效深度>5.5
