wuji-technology/wuji-description/hand2/hand2_beta1/attachment/wuji-hand2-description-left-mount_beta1.pdf

2×M4×0.5细牙 6H 螺纹有效深度>4; M3×0.5 6H 螺牙有效深度>5.5
