wuji-technology/wuji-description/(commit log)

2026-02-28 Release v0.1.0
    [finger1_link1.STL, finger1_link2.STL, finger1_link3.STL, finger1_link4.STL, finger1_tip_link.STL, finger2_link1.STL, finger2_link2.STL, finger2_link3.STL]
2026-05-08 Release v1.1.0 (#2)
    [arm_link.STL, arm_link1.STL, arm_link2.STL, docking-ros.urdf, docking.urdf, docking.xml, finger1_link1.STL, finger1_link2.STL]
2026-05-18 Release v2026.05.18 (#4)
    [Direct-Adapter-Mount.step, Impact-Resistant-Adapter.step, WH_simplified_left_frame&temporarytips.STEP, WH_simplified_right_frame&temporarytips.STEP, arm_link.STL, arm_link1.STL, arm_link2.STL, docking-ros.urdf]
2026-05-19 Release v2026.05.19 (#5)
    [left-ros.urdf, left.urdf, left.xml]
2026-06-04 Release v2026.06.04 (#6)
    [EMFTXC_topcover.step, base_link_RX.STL, base_link_TX.STL, glove-attachment.step, left.urdf, right.urdf]
2026-06-10 Release v2026.6.8 (#12)
    [Assembly.STEP, BOM.xlsx, Base.3mf]
2026-06-10 Release v2026.6.10 (#13)
    [l_index_finger_distal.STL, l_index_finger_middle.STL, l_index_finger_proximal.STL, l_index_finger_proximal_abd.STL, l_index_finger_tip.STL, l_middle_finger_distal.STL, l_middle_finger_middle.STL, l_middle_finger_proximal.STL]
2026-06-10 Release v2026.6.11 (#14)
    [left.xml, right.xml]
2026-06-12 Release v2026.6.12 (#15)
    [Wuji-Hand2-Adapter-Mount-Beta1.step, Wuji-Hand2-Beta1-left.step, Wuji-Hand2-Beta1-right.step]
2026-06-29 Release v2026.6.27 (#16)
    [Wuji-Hand2-Adapter-Mount-Beta1.step, Wuji-Hand2-Beta1-left.step, Wuji-Hand2-Beta1-right.step, l_base_link.STL, l_index_finger_distal.STL, l_index_finger_middle.STL, l_index_finger_proximal.STL, l_index_finger_proximal_abd.STL]
2026-07-14 Release v2026.7.14 (#17)
    [Pico-tracker-attachment.STEP, Wuji-glove-attachment.STEP, left-ros.urdf, right-ros.urdf]
2026-07-23 Release v2026.7.23 (#18)
    [Wuji-Hand2-Adapter-Mount-Beta1.step, Wuji-Hand2-Beta1-left.step, Wuji-Hand2-Beta1-right.step, l_base_link.STL, l_index_finger_distal.STL, l_index_finger_middle.STL, l_index_finger_proximal.STL, l_index_finger_proximal_abd.STL]
2026-08-03 Release v2026.8.3 (#19)
    [Pico-controller-attachment.STEP]
2026-08-14 Release v2026.8.14 (#20)
    [l_index_finger_distal.STL, l_index_finger_middle.STL, l_index_finger_proximal.STL, l_index_finger_proximal_abd.STL, l_index_finger_tip.STL, l_index_finger_tip_sensor_frame.STL, l_middle_finger_distal.STL, l_middle_finger_middle.STL]
2026-08-19 Release v2026.8.19 (#21)
    [left-ros.urdf, left_with_mount-ros.urdf, right-ros.urdf, right_with_mount-ros.urdf]
2026-09-11 Release v2026.9.11 (#24)
    [base_link_TX.STL]
